JakovBegovic/Robot-upravljan-kontrolerom-v2/README.md

# Robot upravljan kontrolerom v2
[][cc-by-nc-sa]
<br>

Samostalan projekt studenta 2. godine diplomskog studija Jakova Begovića razvijen u svrhu učenja i razvijanja znanja. <br><br>
Koncipiran kao unaprjeđenje [projekta](https://github.com/JakovBegovic/Robot-upravljan-kontrolerom) razvijenog na 3. godini preddiplomskog studija. <br>
Uzima inspiraciju od prvotnog projekta i unaprjeđuje njegove značajke u svrhu povećane energetske učinkovitosti, korisničkog iskustva i funkcionalnosti.<br><br>

### Stanje razvoja dizajna za v2:
  - Razvijeni programski kodovi na prototipima električnih shema robot-auta i kontrolera ✅
  - Razvijene električne sheme robot-auta i kontrolera ✅
  - Dizajnirani PCB-i robot-auta i kontrolera ✅
  - Izrađeni PCB-i robot-auta i kontrolera ✅
  - Nabavljeni elektronički dijelovi robot-auta i kontrolera ✅
  - Razvijeni 2D modeli kućišta robot-auta i kontrolera ✅
  - Razvijeni 3D modeli kućišta robot-auta i kontrolera ❌
  - Isprintani 3D modeli kućišta robot-auta i kontrolera ❌
  - Elektronički dijelovi robot-auta i kontrolera povezani na PCB-ima ❌
  - Razvijeni programski kod prilagođen za sustave na PCB-ima ❌

<br>

### Korišteni alati:
  - KiCAD
    - razvoj električne sheme
    - dizajn PCB-a
      
  - LTSpice
    - simuliranje rada diskretnih sklopovskih komponenti
  
  - LibreCAD     
    - dizajn obruba PCB-a i 2D modela kućišta

  - VSC + PlatformIO
    - razvoj programskog koda

<br>

### Izjava o korištenju generativne umjetne inteligencije:
Cjelokupni razvoj sustava se temelji na Internetskim izvorima, knjigama i nastavnim materijalima Sveučilišta u Zagrebu. Generativna umjetna inteligencija nije korištena za razvoj ovoga sustava.

<br><br>
This work is licensed under a
[Creative Commons Attribution-NonCommercial-ShareAlike 4.0 International License][cc-by-nc-sa].

[][cc-by-nc-sa]

[cc-by-nc-sa]: http://creativecommons.org/licenses/by-nc-sa/4.0/
[cc-by-nc-sa-image]: https://licensebuttons.net/l/by-nc-sa/4.0/88x31.png
[cc-by-nc-sa-shield]: https://img.shields.io/badge/License-CC%20BY--NC--SA%204.0-lightgrey.svg
