JakovBegovic/Robot-upravljan-kontrolerom-v2/CAD modeli/2D/RC podloga.dxf

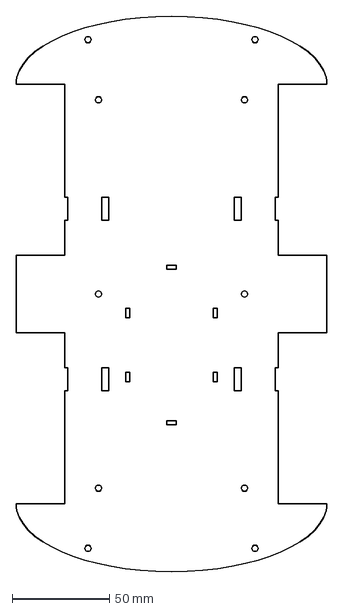
[picture p1: CAD file, 2026-11-08]
CAD modeli/2D/RC podloga.dxf
160.0 x 286.0 mm
