JakovBegovic/Robot-upravljan-kontrolerom-v2/CAD modeli/3D/Kontroler/K Kuciste.FCStd

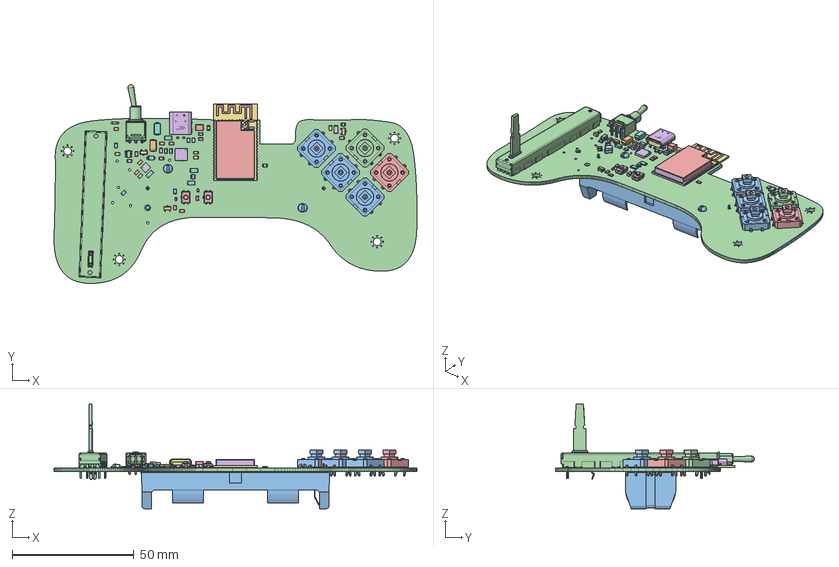
[picture p2: CAD file, 2026-11-08]
CAD modeli/3D/Kontroler/K Kuciste.FCStd
148.9 x 81.5 x 42.9 mm
C_0805_2012Metric
R_0805_2012Metric
R_0805_2012Metric002
C_1210_3225Metric
EVQP2B02B2
C_0805_2012Metric002
R_1206_3216Metric
D_SOD-882D
R_0805_2012Metric004
SOT-23-6
EVQP2B02B001
R_0805_2012Metric006
R_0805_2012Metric008
60816e3e-9268-11ed-8af4-a0cec80452fd_part
6081710e-9268-11ed-8af4-a0cec80452fd_part
6081737a-9268-11ed-8af4-a0cec80452fd_part
D_SOD_523
C0201_20210301.STEP^C0201_20210301.STEP_Submodel-C0201_part_DesignRootModel_PCB_ESP32-WROVER-E_V1(2)_PCB_ESP32-WROVER-E_V1
C0201_20210301.STEP^C0201_20210301.STEP_Submodel-C0201_part_DesignRootModel_PCB_ESP32-WROVER-E_V1(2)_PCB_ESP32-WROVER-E_V001
C0201_20210301.STEP^C0201_20210301.STEP_Submodel-C0201_part_DesignRootModel_PCB_ESP32-WROVER-E_V1(2)_PCB_ESP32-WROVER-E_V002
C0201_20210301.STEP^C0201_20210301.STEP_Submodel-C0201_part_DesignRootModel_PCB_ESP32-WROVER-E_V1(2)_PCB_ESP32-WROVER-E_V003
C0201_20210301.STEP^C0201_20210301.STEP_Submodel-C0201_part_DesignRootModel_PCB_ESP32-WROVER-E_V1(2)_PCB_ESP32-WROVER-E_V004
C0201_20210301.STEP^C0201_20210301.STEP_Submodel-C0201_part_DesignRootModel_PCB_ESP32-WROVER-E_V1(2)_PCB_ESP32-WROVER-E_V005
C0201_20210301.STEP^C0201_20210301.STEP_Submodel-C0201_part_DesignRootModel_PCB_ESP32-WROVER-E_V1(2)_PCB_ESP32-WROVER-E_V006
C0201_20210301.STEP^C0201_20210301.STEP_Submodel-C0201_part_DesignRootModel_PCB_ESP32-WROVER-E_V1(2)_PCB_ESP32-WROVER-E_V007
C0201_20210301.STEP^C0201_20210301.STEP_Submodel-C0201_part_DesignRootModel_PCB_ESP32-WROVER-E_V1(2)_PCB_ESP32-WROVER-E_V008
C0201_20210301.STEP^C0201_20210301.STEP_Submodel-C0201_part_DesignRootModel_PCB_ESP32-WROVER-E_V1(2)_PCB_ESP32-WROVER-E_V009
C0201_20210301.STEP^C0201_20210301.STEP_Submodel-C0201_part_DesignRootModel_PCB_ESP32-WROVER-E_V1(2)_PCB_ESP32-WROVER-E_V010
C0201_20210301.STEP^C0201_20210301.STEP_Submodel-C0201_part_DesignRootModel_PCB_ESP32-WROVER-E_V1(2)_PCB_ESP32-WROVER-E_V011
C0201_20210301.STEP^C0201_20210301.STEP_Submodel-C0201_part_DesignRootModel_PCB_ESP32-WROVER-E_V1(2)_PCB_ESP32-WROVER-E_V012
C0201_20210301.STEP^C0201_20210301.STEP_Submodel-C0201_part_DesignRootModel_PCB_ESP32-WROVER-E_V1(2)_PCB_ESP32-WROVER-E_V013
DFN1006.STEP^DFN1006.STEP_Submodel-SOD882_part_DesignRootModel_PCB_ESP32-WROVER-E_V1(2)_PCB_ESP32-WROVER-E_V1
ESP32_5x5_20210301.STEP^ESP32_5x5_20210301.STEP_Submodel-QFN48EB_0P35_5_part_DesignRootModel_PCB_ESP32-WROVER-E_V1(2)_PCB_ESP32-WROVER-E_V1
C0402_20210301.STEP^C0402_20210301.STEP_Submodel-C0402_part_DesignRootModel_PCB_ESP32-WROVER-E_V1(2)_PCB_ESP32-WROVER-E_V1
trace_1^Submodel-MINI_ANT_TYPEB_1501846164_part_DesignRootModel_PCB_ESP32-WROVER-E_V1(2)_PCB_ESP32-WROVER-E_V1
XTAL3225_20210301.STEP^XTAL3225_20210301.STEP_Submodel-3225_part_DesignRootModel_PCB_ESP32-WROVER-E_V1(2)_PCB_ESP32-WROVER-E_V1
R0201_20210301.STEP^R0201_20210301.STEP_Submodel-R0201A_part_DesignRootModel_PCB_ESP32-WROVER-E_V1(2)_PCB_ESP32-WROVER-E_V1
R0201_20210301.STEP^R0201_20210301.STEP_Submodel-R0201_part_DesignRootModel_PCB_ESP32-WROVER-E_V1(2)_PCB_ESP32-WROVER-E_V1
L0201_20210301.STEP^L0201_20210301.STEP_Submodel-L0201_part_DesignRootModel_PCB_ESP32-WROVER-E_V1(2)_PCB_ESP32-WROVER-E_V1
R0201_20210301.STEP^R0201_20210301.STEP_Submodel-R0201_part_DesignRootModel_PCB_ESP32-WROVER-E_V1(2)_PCB_ESP32-WROVER-E_V001
R0201_20210301.STEP^R0201_20210301.STEP_Submodel-R0201_part_DesignRootModel_PCB_ESP32-WROVER-E_V1(2)_PCB_ESP32-WROVER-E_V002
R0201_20210301.STEP^R0201_20210301.STEP_Submodel-R0201_part_DesignRootModel_PCB_ESP32-WROVER-E_V1(2)_PCB_ESP32-WROVER-E_V003
L0201_20210301.STEP^L0201_20210301.STEP_Submodel-L0201_part_DesignRootModel_PCB_ESP32-WROVER-E_V1(2)_PCB_ESP32-WROVER-E_V001
PSRAM_20210301.STEP^PSRAM_20210301.STEP_Submodel-SOIC-8P_part_DesignRootModel_PCB_ESP32-WROVER-E_V1(2)_PCB_ESP32-WROVER-E_V1
R0201_20210301.STEP^R0201_20210301.STEP_Submodel-R0201_part_DesignRootModel_PCB_ESP32-WROVER-E_V1(2)_PCB_ESP32-WROVER-E_V004
R0201_20210301.STEP^R0201_20210301.STEP_Submodel-R0201_part_DesignRootModel_PCB_ESP32-WROVER-E_V1(2)_PCB_ESP32-WROVER-E_V005
R0201_20210301.STEP^R0201_20210301.STEP_Submodel-R0201_part_DesignRootModel_PCB_ESP32-WROVER-E_V1(2)_PCB_ESP32-WROVER-E_V006
R0201_20210301.STEP^R0201_20210301.STEP_Submodel-R0201_part_DesignRootModel_PCB_ESP32-WROVER-E_V1(2)_PCB_ESP32-WROVER-E_V007
R0201_20210301.STEP^R0201_20210301.STEP_Submodel-R0201_part_DesignRootModel_PCB_ESP32-WROVER-E_V1(2)_PCB_ESP32-WROVER-E_V008
SOIC8_208_20210301.STEP^SOIC8_208_20210301.STEP_Submodel-SOIC08-WN_part_DesignRootModel_PCB_ESP32-WROVER-E_V1(2)_PCB_ESP32-WROVER-E_V1
C0201_20210301.STEP^C0201_20210301.STEP_Submodel-C0201_part_DesignRootModel_PCB_ESP32-WROVER-E_V1(2)_PCB_ESP32-WROVER-E_V014
uid__4-19^DesignRootModel_PCB_ESP32-WROVER-E_V1(2)_PCB_ESP32-WROVER-E_V1
uid__4-20^DesignRootModel_PCB_ESP32-WROVER-E_V1(2)_PCB_ESP32-WROVER-E_V1
uid__4-21^DesignRootModel_PCB_ESP32-WROVER-E_V1(2)_PCB_ESP32-WROVER-E_V1
uid__4-22^DesignRootModel_PCB_ESP32-WROVER-E_V1(2)_PCB_ESP32-WROVER-E_V1
uid__4-23^DesignRootModel_PCB_ESP32-WROVER-E_V1(2)_PCB_ESP32-WROVER-E_V1
uid__4-24^DesignRootModel_PCB_ESP32-WROVER-E_V1(2)_PCB_ESP32-WROVER-E_V1
uid__4-25^DesignRootModel_PCB_ESP32-WROVER-E_V1(2)_PCB_ESP32-WROVER-E_V1
uid__4-26^DesignRootModel_PCB_ESP32-WROVER-E_V1(2)_PCB_ESP32-WROVER-E_V1
uid__4-27^DesignRootModel_PCB_ESP32-WROVER-E_V1(2)_PCB_ESP32-WROVER-E_V1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
