JakovBegovic/Robot-upravljan-kontrolerom-v2/CAD modeli/3D/Robot-auto/Podloga.FCStd

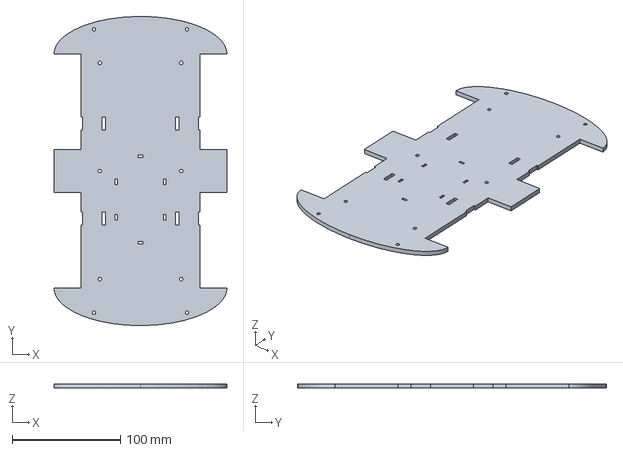
[picture p3: CAD file, 2026-11-08]
CAD modeli/3D/Robot-auto/Podloga.FCStd
160.0 x 286.0 x 4.00 mm
