JakovBegovic/Robot-upravljan-kontrolerom-v2/Električne sheme/Robot-auto/Robot-auto.step

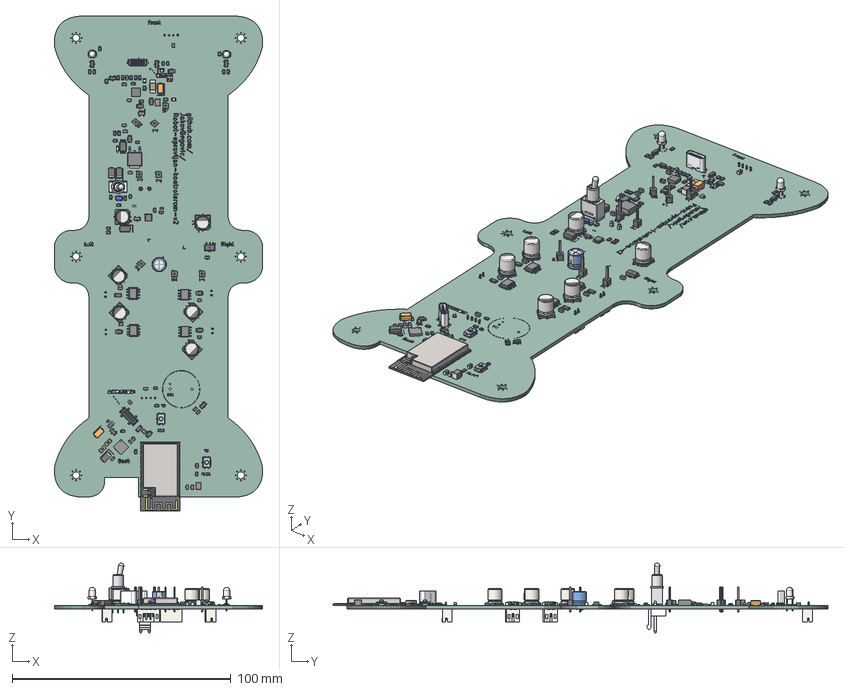
[picture p4: CAD file, 2026-10-22]
Električne sheme/Robot-auto/Robot-auto.step
95.3 x 226.3 x 32.0 mm
025002-01643-a.testprt x 2
D_SOD_523 x 2
R_0805_2012Metric x 41
C_0805_2012Metric x 20
C_1210_3225Metric x 2
PinHeader_1x01_P254mm_Vertical x 8
R_1206_3216Metric x 10
SOT-23 x 6
CP_Elec_63x77 x 6
HSMG-C110
PinsArrayLR x 2
LED_D3.0mm_Clear x 2
D_SMA x 4
C_0603_1608Metric
ThermalPin
PinsArrayTB
PinsArrayL x 2
PinsArrayR
USB4130-GF-C_PART1
TSSOP-8_4.4x3mm_P0.65mm
LED_0805_2012Metric x 3
USB4120-03-C
Fuse_1206_3216Metric
C0201_20210301.STEP^C0201_20210301.STEP_Submodel-C0201_part_ DesignRootModel_PCB_ESP32-WROVER-E_V1(2)_PCB_ESP32-WROVER-E_V1 x 15
DFN1006.STEP^DFN1006.STEP_Submodel-SOD882_part_DesignRootModel_PCB_ ESP32-WROVER-E_V1(2)_PCB_ESP32-WROVER-E_V1
ESP32_5x5_20210301.STEP^ESP32_5x5_20210301.STEP_Submodel-QFN48EB_0P35_ 5_part_DesignRootModel_PCB_ESP32-WROVER-E_V1(2)_PCB_ESP32-WROVER-E_V1
C0402_20210301.STEP^C0402_20210301.STEP_Submodel-C0402_part_ DesignRootModel_PCB_ESP32-WROVER-E_V1(2)_PCB_ESP32-WROVER-E_V1
trace_1^Submodel-MINI_ANT_TYPEB_1501846164_part_DesignRootModel_PCB_ ESP32-WROVER-E_V1(2)_PCB_ESP32-WROVER-E_V1
XTAL3225_20210301.STEP^XTAL3225_20210301.STEP_Submodel-3225_part_ DesignRootModel_PCB_ESP32-WROVER-E_V1(2)_PCB_ESP32-WROVER-E_V1
R0201_20210301.STEP^R0201_20210301.STEP_Submodel-R0201A_part_ DesignRootModel_PCB_ESP32-WROVER-E_V1(2)_PCB_ESP32-WROVER-E_V1
R0201_20210301.STEP^R0201_20210301.STEP_Submodel-R0201_part_ DesignRootModel_PCB_ESP32-WROVER-E_V1(2)_PCB_ESP32-WROVER-E_V1 x 9
L0201_20210301.STEP^L0201_20210301.STEP_Submodel-L0201_part_ DesignRootModel_PCB_ESP32-WROVER-E_V1(2)_PCB_ESP32-WROVER-E_V1 x 2
PSRAM_20210301.STEP^PSRAM_20210301.STEP_Submodel-SOIC-8P_part_ DesignRootModel_PCB_ESP32-WROVER-E_V1(2)_PCB_ESP32-WROVER-E_V1
SOIC8_208_20210301.STEP^SOIC8_208_20210301.STEP_Submodel-SOIC08-WN_ part_DesignRootModel_PCB_ESP32-WROVER-E_V1(2)_PCB_ESP32-WROVER-E_V1
uid__4-19^DesignRootModel_PCB_ESP32-WROVER-E_V1(2)_PCB_ESP32-WROVER-E_ V1
uid__4-20^DesignRootModel_PCB_ESP32-WROVER-E_V1(2)_PCB_ESP32-WROVER-E_ V1
uid__4-21^DesignRootModel_PCB_ESP32-WROVER-E_V1(2)_PCB_ESP32-WROVER-E_ V1
uid__4-22^DesignRootModel_PCB_ESP32-WROVER-E_V1(2)_PCB_ESP32-WROVER-E_ V1
uid__4-23^DesignRootModel_PCB_ESP32-WROVER-E_V1(2)_PCB_ESP32-WROVER-E_ V1
uid__4-24^DesignRootModel_PCB_ESP32-WROVER-E_V1(2)_PCB_ESP32-WROVER-E_ V1
uid__4-25^DesignRootModel_PCB_ESP32-WROVER-E_V1(2)_PCB_ESP32-WROVER-E_ V1
uid__4-26^DesignRootModel_PCB_ESP32-WROVER-E_V1(2)_PCB_ESP32-WROVER-E_ V1
uid__4-27^DesignRootModel_PCB_ESP32-WROVER-E_V1(2)_PCB_ESP32-WROVER-E_ V1
uid__4-28^DesignRootModel_PCB_ESP32-WROVER-E_V1(2)_PCB_ESP32-WROVER-E_ V1
uid__4-29^DesignRootModel_PCB_ESP32-WROVER-E_V1(2)_PCB_ESP32-WROVER-E_ V1
uid__4-30^DesignRootModel_PCB_ESP32-WROVER-E_V1(2)_PCB_ESP32-WROVER-E_ V1
uid__4-31^DesignRootModel_PCB_ESP32-WROVER-E_V1(2)_PCB_ESP32-WROVER-E_ V1
uid__4-32^DesignRootModel_PCB_ESP32-WROVER-E_V1(2)_PCB_ESP32-WROVER-E_ V1
uid__4-33^DesignRootModel_PCB_ESP32-WROVER-E_V1(2)_PCB_ESP32-WROVER-E_ V1
uid__4-34^DesignRootModel_PCB_ESP32-WROVER-E_V1(2)_PCB_ESP32-WROVER-E_ V1
uid__4-35^DesignRootModel_PCB_ESP32-WROVER-E_V1(2)_PCB_ESP32-WROVER-E_ V1
uid__4-36^DesignRootModel_PCB_ESP32-WROVER-E_V1(2)_PCB_ESP32-WROVER-E_ V1
uid__4-37^DesignRootModel_PCB_ESP32-WROVER-E_V1(2)_PCB_ESP32-WROVER-E_ V1
uid__4-38^DesignRootModel_PCB_ESP32-WROVER-E_V1(2)_PCB_ESP32-WROVER-E_ V1
uid__4-39^DesignRootModel_PCB_ESP32-WROVER-E_V1(2)_PCB_ESP32-WROVER-E_ V1
uid__4-40^DesignRootModel_PCB_ESP32-WROVER-E_V1(2)_PCB_ESP32-WROVER-E_ V1
uid__4-41^DesignRootModel_PCB_ESP32-WROVER-E_V1(2)_PCB_ESP32-WROVER-E_ V1
uid__4-42^DesignRootModel_PCB_ESP32-WROVER-E_V1(2)_PCB_ESP32-WROVER-E_ V1
uid__4-43^DesignRootModel_PCB_ESP32-WROVER-E_V1(2)_PCB_ESP32-WROVER-E_ V1
uid__4-44^DesignRootModel_PCB_ESP32-WROVER-E_V1(2)_PCB_ESP32-WROVER-E_ V1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
