JakovBegovic/Robot-upravljan-kontrolerom-v2/CAD modeli/3D/Kontroler/Kontroler.step

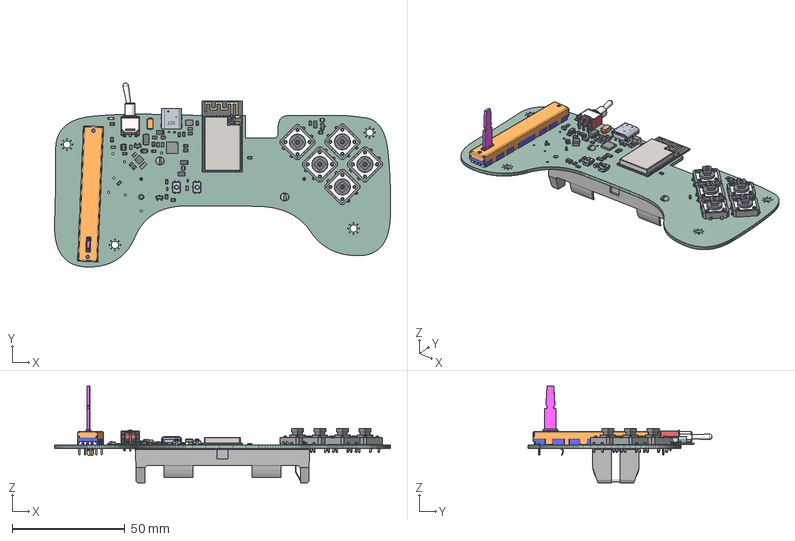
[picture p5: CAD file, 2026-11-04]
CAD modeli/3D/Kontroler/Kontroler.step
148.9 x 81.5 x 42.9 mm
C_0805_2012Metric x 10
R_0805_2012Metric x 19
C_1210_3225Metric
EVQP2B02B2 x 2
R_1206_3216Metric x 3
D_SOD-882D x 2
SOT-23-6
6081697a-9268-11ed-8af4-a0cec80452fd_part
60816e3e-9268-11ed-8af4-a0cec80452fd_part
6081710e-9268-11ed-8af4-a0cec80452fd_part
6081737a-9268-11ed-8af4-a0cec80452fd_part
D_SOD_523 x 2
C0201_20210301.STEP^C0201_20210301.STEP_Submodel-C0201_part_ DesignRootModel_PCB_ESP32-WROVER-E_V1(2)_PCB_ESP32-WROVER-E_V1 x 15
DFN1006.STEP^DFN1006.STEP_Submodel-SOD882_part_DesignRootModel_PCB_ ESP32-WROVER-E_V1(2)_PCB_ESP32-WROVER-E_V1
ESP32_5x5_20210301.STEP^ESP32_5x5_20210301.STEP_Submodel-QFN48EB_0P35_ 5_part_DesignRootModel_PCB_ESP32-WROVER-E_V1(2)_PCB_ESP32-WROVER-E_V1
C0402_20210301.STEP^C0402_20210301.STEP_Submodel-C0402_part_ DesignRootModel_PCB_ESP32-WROVER-E_V1(2)_PCB_ESP32-WROVER-E_V1
trace_1^Submodel-MINI_ANT_TYPEB_1501846164_part_DesignRootModel_PCB_ ESP32-WROVER-E_V1(2)_PCB_ESP32-WROVER-E_V1
XTAL3225_20210301.STEP^XTAL3225_20210301.STEP_Submodel-3225_part_ DesignRootModel_PCB_ESP32-WROVER-E_V1(2)_PCB_ESP32-WROVER-E_V1
R0201_20210301.STEP^R0201_20210301.STEP_Submodel-R0201A_part_ DesignRootModel_PCB_ESP32-WROVER-E_V1(2)_PCB_ESP32-WROVER-E_V1
R0201_20210301.STEP^R0201_20210301.STEP_Submodel-R0201_part_ DesignRootModel_PCB_ESP32-WROVER-E_V1(2)_PCB_ESP32-WROVER-E_V1 x 9
L0201_20210301.STEP^L0201_20210301.STEP_Submodel-L0201_part_ DesignRootModel_PCB_ESP32-WROVER-E_V1(2)_PCB_ESP32-WROVER-E_V1 x 2
PSRAM_20210301.STEP^PSRAM_20210301.STEP_Submodel-SOIC-8P_part_ DesignRootModel_PCB_ESP32-WROVER-E_V1(2)_PCB_ESP32-WROVER-E_V1
SOIC8_208_20210301.STEP^SOIC8_208_20210301.STEP_Submodel-SOIC08-WN_ part_DesignRootModel_PCB_ESP32-WROVER-E_V1(2)_PCB_ESP32-WROVER-E_V1
uid__4-19^DesignRootModel_PCB_ESP32-WROVER-E_V1(2)_PCB_ESP32-WROVER-E_ V1
uid__4-20^DesignRootModel_PCB_ESP32-WROVER-E_V1(2)_PCB_ESP32-WROVER-E_ V1
uid__4-21^DesignRootModel_PCB_ESP32-WROVER-E_V1(2)_PCB_ESP32-WROVER-E_ V1
uid__4-22^DesignRootModel_PCB_ESP32-WROVER-E_V1(2)_PCB_ESP32-WROVER-E_ V1
uid__4-23^DesignRootModel_PCB_ESP32-WROVER-E_V1(2)_PCB_ESP32-WROVER-E_ V1
uid__4-24^DesignRootModel_PCB_ESP32-WROVER-E_V1(2)_PCB_ESP32-WROVER-E_ V1
uid__4-25^DesignRootModel_PCB_ESP32-WROVER-E_V1(2)_PCB_ESP32-WROVER-E_ V1
uid__4-26^DesignRootModel_PCB_ESP32-WROVER-E_V1(2)_PCB_ESP32-WROVER-E_ V1
uid__4-27^DesignRootModel_PCB_ESP32-WROVER-E_V1(2)_PCB_ESP32-WROVER-E_ V1
uid__4-28^DesignRootModel_PCB_ESP32-WROVER-E_V1(2)_PCB_ESP32-WROVER-E_ V1
uid__4-29^DesignRootModel_PCB_ESP32-WROVER-E_V1(2)_PCB_ESP32-WROVER-E_ V1
uid__4-30^DesignRootModel_PCB_ESP32-WROVER-E_V1(2)_PCB_ESP32-WROVER-E_ V1
uid__4-31^DesignRootModel_PCB_ESP32-WROVER-E_V1(2)_PCB_ESP32-WROVER-E_ V1
uid__4-32^DesignRootModel_PCB_ESP32-WROVER-E_V1(2)_PCB_ESP32-WROVER-E_ V1
uid__4-33^DesignRootModel_PCB_ESP32-WROVER-E_V1(2)_PCB_ESP32-WROVER-E_ V1
uid__4-34^DesignRootModel_PCB_ESP32-WROVER-E_V1(2)_PCB_ESP32-WROVER-E_ V1
uid__4-35^DesignRootModel_PCB_ESP32-WROVER-E_V1(2)_PCB_ESP32-WROVER-E_ V1
uid__4-36^DesignRootModel_PCB_ESP32-WROVER-E_V1(2)_PCB_ESP32-WROVER-E_ V1
uid__4-37^DesignRootModel_PCB_ESP32-WROVER-E_V1(2)_PCB_ESP32-WROVER-E_ V1
uid__4-38^DesignRootModel_PCB_ESP32-WROVER-E_V1(2)_PCB_ESP32-WROVER-E_ V1
uid__4-39^DesignRootModel_PCB_ESP32-WROVER-E_V1(2)_PCB_ESP32-WROVER-E_ V1
uid__4-40^DesignRootModel_PCB_ESP32-WROVER-E_V1(2)_PCB_ESP32-WROVER-E_ V1
uid__4-41^DesignRootModel_PCB_ESP32-WROVER-E_V1(2)_PCB_ESP32-WROVER-E_ V1
uid__4-42^DesignRootModel_PCB_ESP32-WROVER-E_V1(2)_PCB_ESP32-WROVER-E_ V1
uid__4-43^DesignRootModel_PCB_ESP32-WROVER-E_V1(2)_PCB_ESP32-WROVER-E_ V1
uid__4-44^DesignRootModel_PCB_ESP32-WROVER-E_V1(2)_PCB_ESP32-WROVER-E_ V1
uid__4-45^DesignRootModel_PCB_ESP32-WROVER-E_V1(2)_PCB_ESP32-WROVER-E_ V1
uid__4-46^DesignRootModel_PCB_ESP32-WROVER-E_V1(2)_PCB_ESP32-WROVER-E_ V1
uid__4-47^DesignRootModel_PCB_ESP32-WROVER-E_V1(2)_PCB_ESP32-WROVER-E_ V1
uid__4-48^DesignRootModel_PCB_ESP32-WROVER-E_V1(2)_PCB_ESP32-WROVER-E_ V1
uid__4-49^DesignRootModel_PCB_ESP32-WROVER-E_V1(2)_PCB_ESP32-WROVER-E_ V1
uid__4-50^DesignRootModel_PCB_ESP32-WROVER-E_V1(2)_PCB_ESP32-WROVER-E_ V1
uid__4-51^DesignRootModel_PCB_ESP32-WROVER-E_V1(2)_PCB_ESP32-WROVER-E_ V1
uid__4-52^DesignRootModel_PCB_ESP32-WROVER-E_V1(2)_PCB_ESP32-WROVER-E_ V1
uid__4-53^DesignRootModel_PCB_ESP32-WROVER-E_V1(2)_PCB_ESP32-WROVER-E_ V1
uid__4-54^DesignRootModel_PCB_ESP32-WROVER-E_V1(2)_PCB_ESP32-WROVER-E_ V1
uid__4-55^DesignRootModel_PCB_ESP32-WROVER-E_V1(2)_PCB_ESP32-WROVER-E_ V1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
