JakovBegovic/Robot-upravljan-kontrolerom-v2/CAD modeli/2D/PCB K obrub.dxf

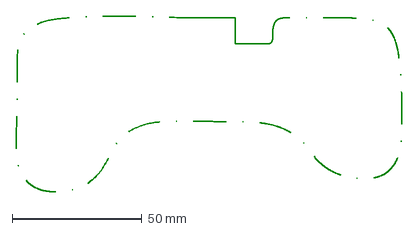
[picture p6: CAD file, 2026-11-08]
CAD modeli/2D/PCB K obrub.dxf
148.9 x 67.7 mm
