JakovBegovic/Robot-upravljan-kontrolerom-v2/CAD modeli/2D/K podloga tlocrt.dxf

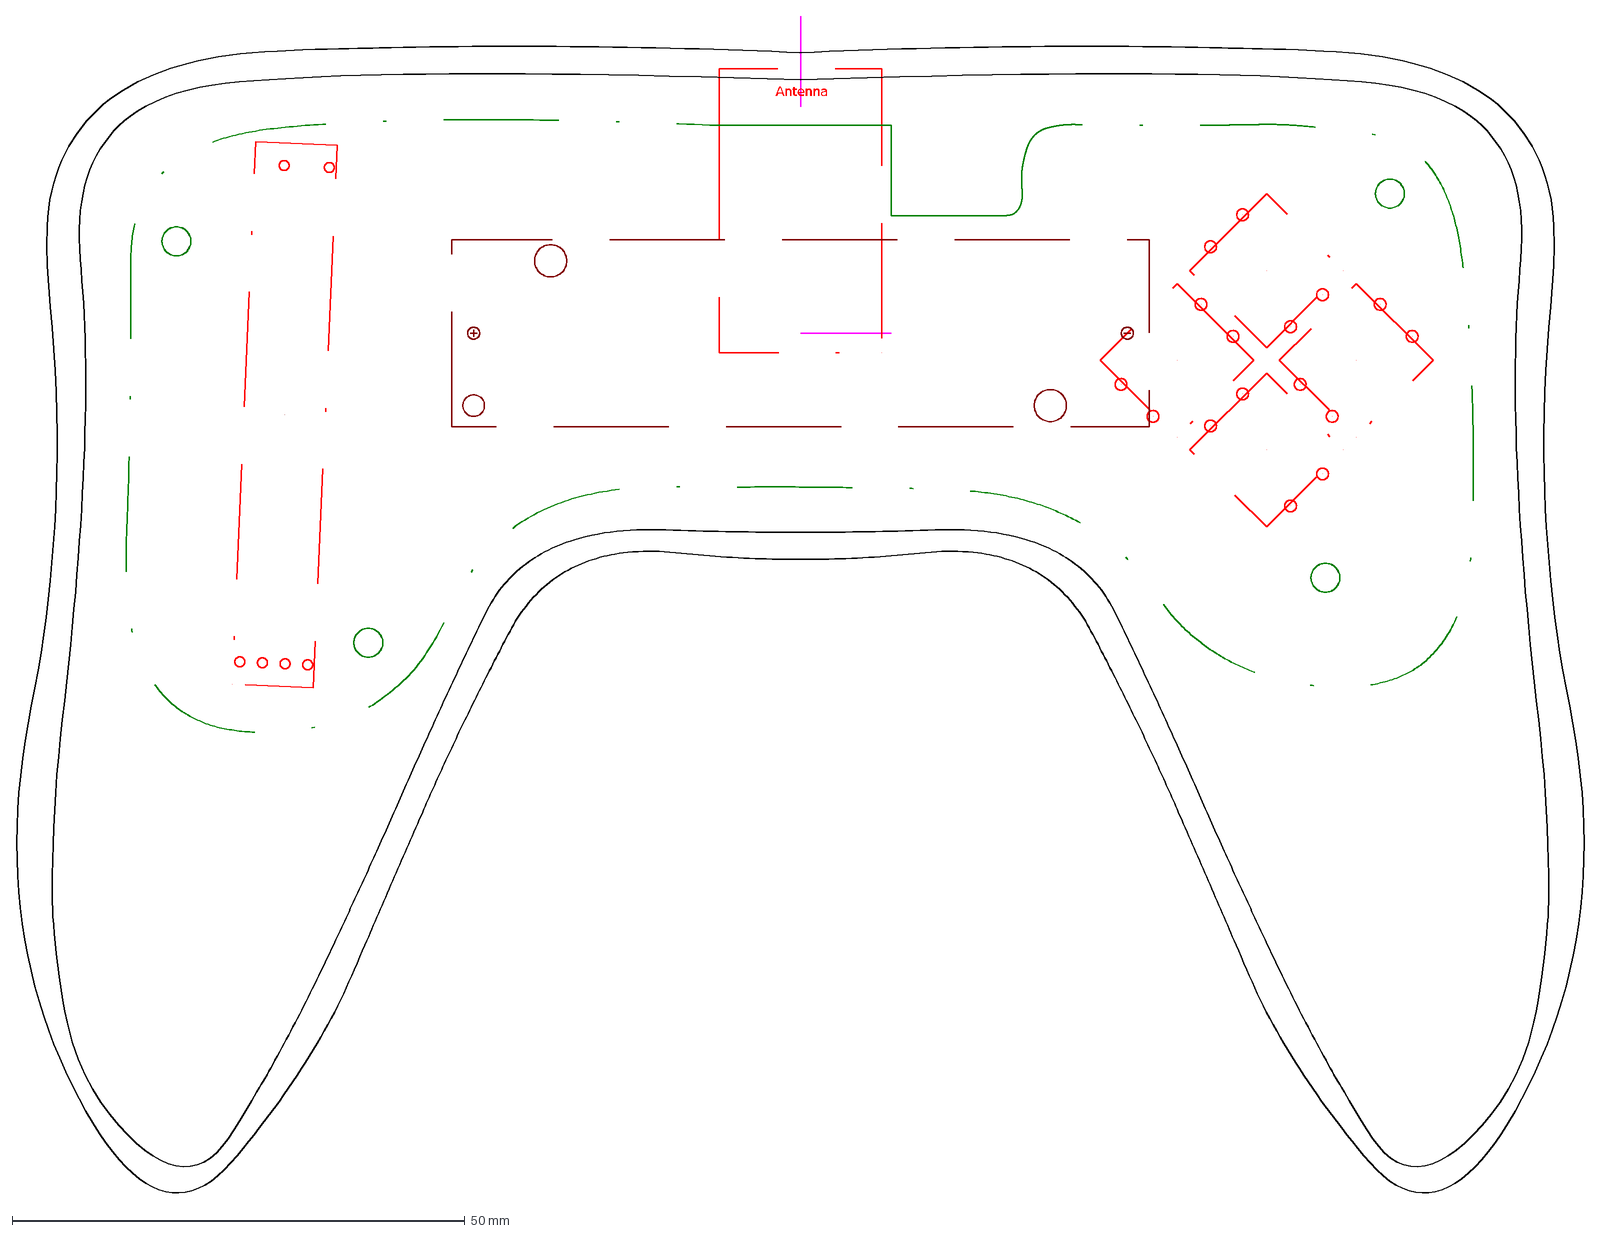
[picture p7: CAD file, 2026-11-08]
CAD modeli/2D/K podloga tlocrt.dxf
Antenna
