JakovBegovic/Robot-upravljan-kontrolerom-v2/CAD modeli/2D/PCB RC obrub.dxf

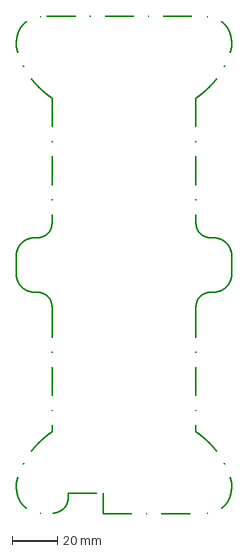
[picture p8: CAD file, 2026-10-21]
CAD modeli/2D/PCB RC obrub.dxf
95.3 x 220.0 mm
