JakovBegovic/Robot-upravljan-kontrolerom-v2/(list of files, cad)

Other CAD files:
CAD modeli/2D/RC Podloga tlocrt.dxf
CAD modeli/3D/Robot-auto/Robot-auto.step
