JakovBegovic/Robot-upravljan-kontrolerom-v2/Električne sheme/Kontroler/Kontroler.pdf

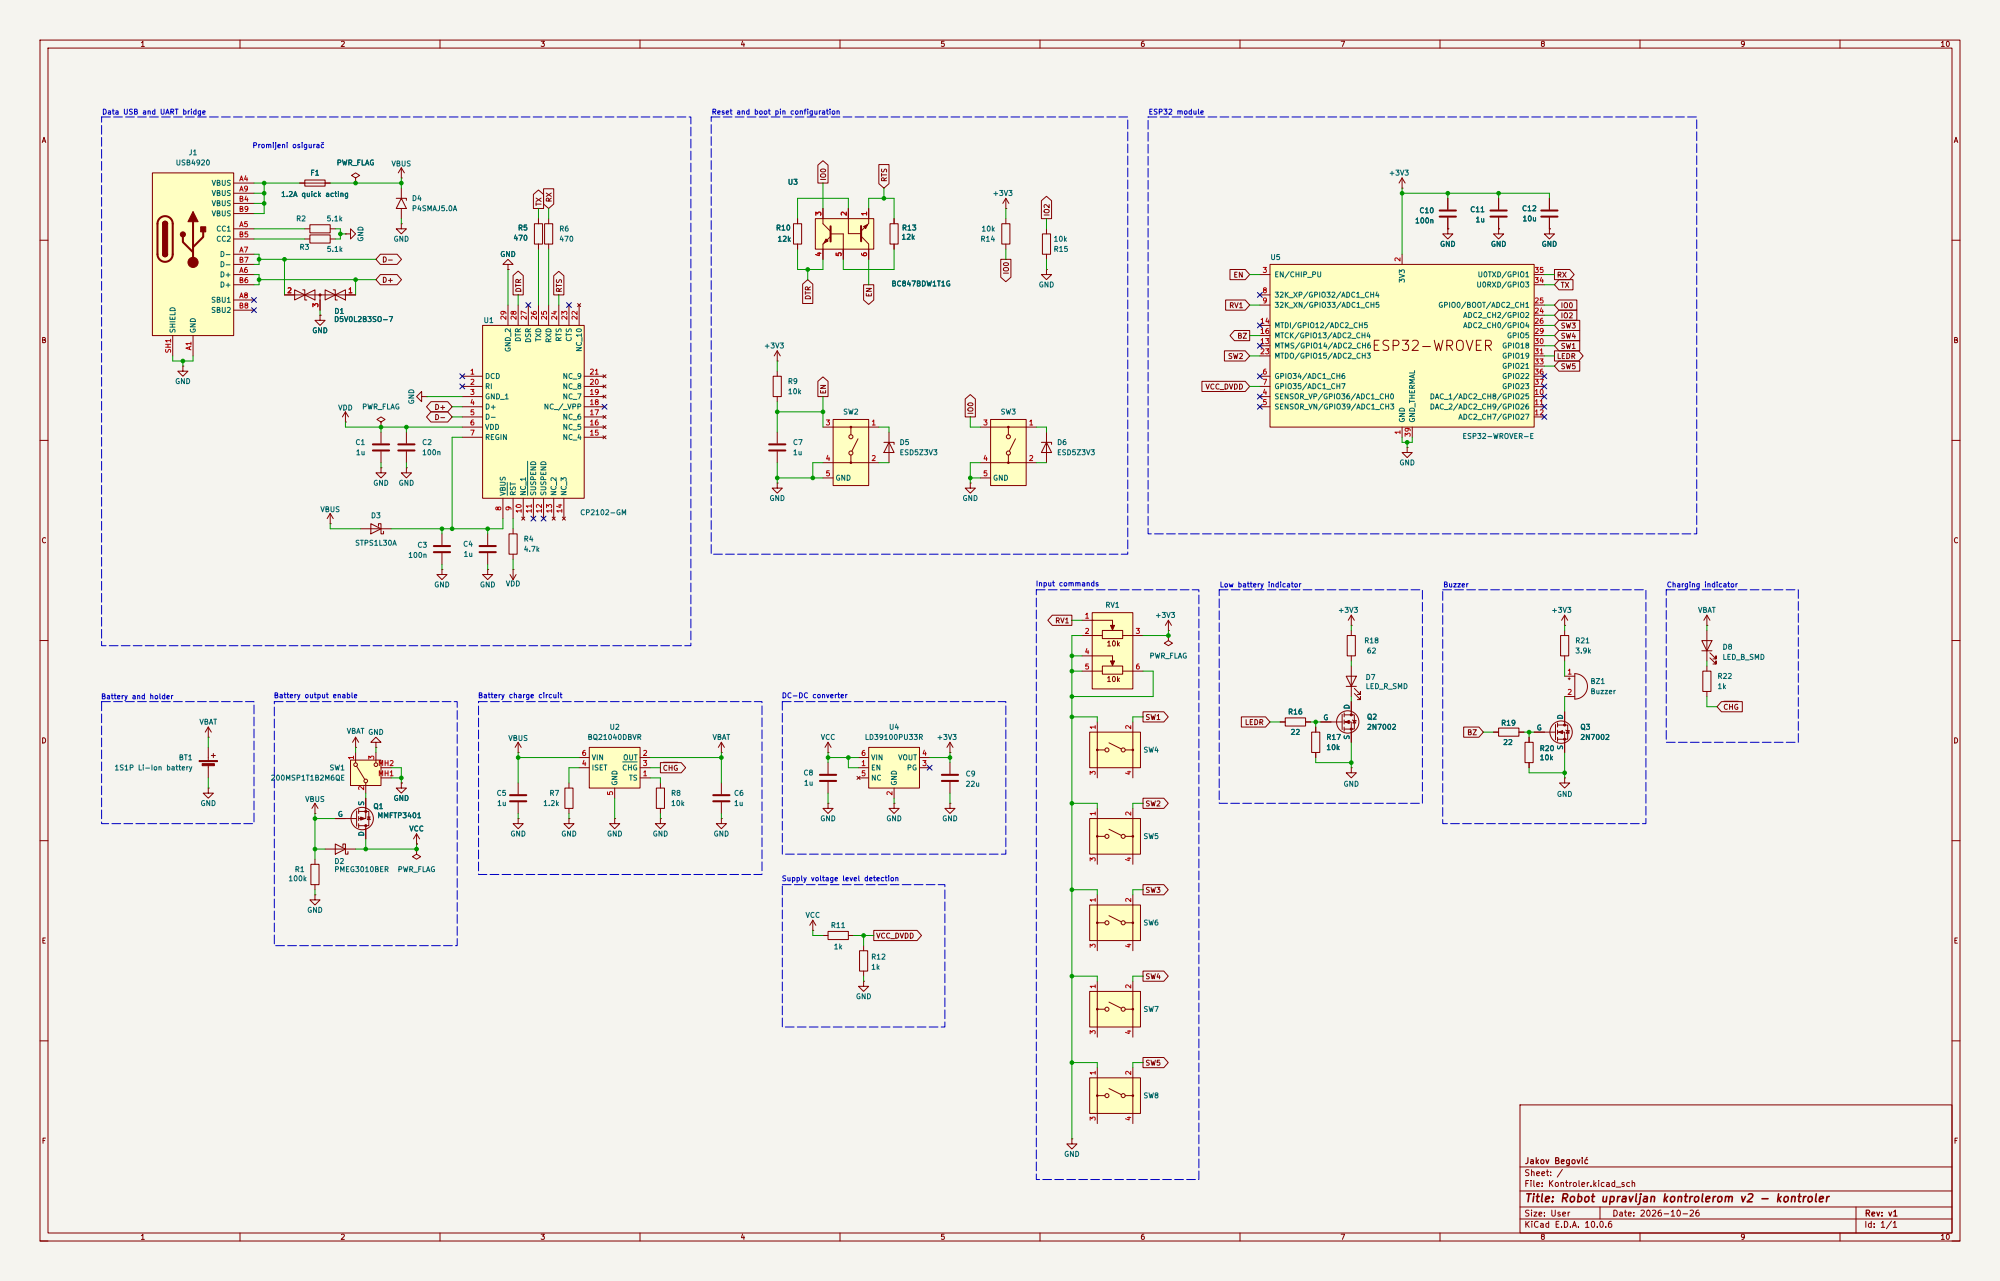
[picture p9: page 1]

Data USB and UART bridge
J1 USB4920 GND

Jakov Begović
Sheet: /
File: Kontroler.kicad_sch
Title: Robot upravljan kontrolerom v2 - kontroler

Size: User | Rev: v1
KiCad E.D.A. 10.0.6 | Id: 1/1
