JakovBegovic/Robot-upravljan-kontrolerom-v2/Električne sheme/Robot-auto/Robot-auto.pdf

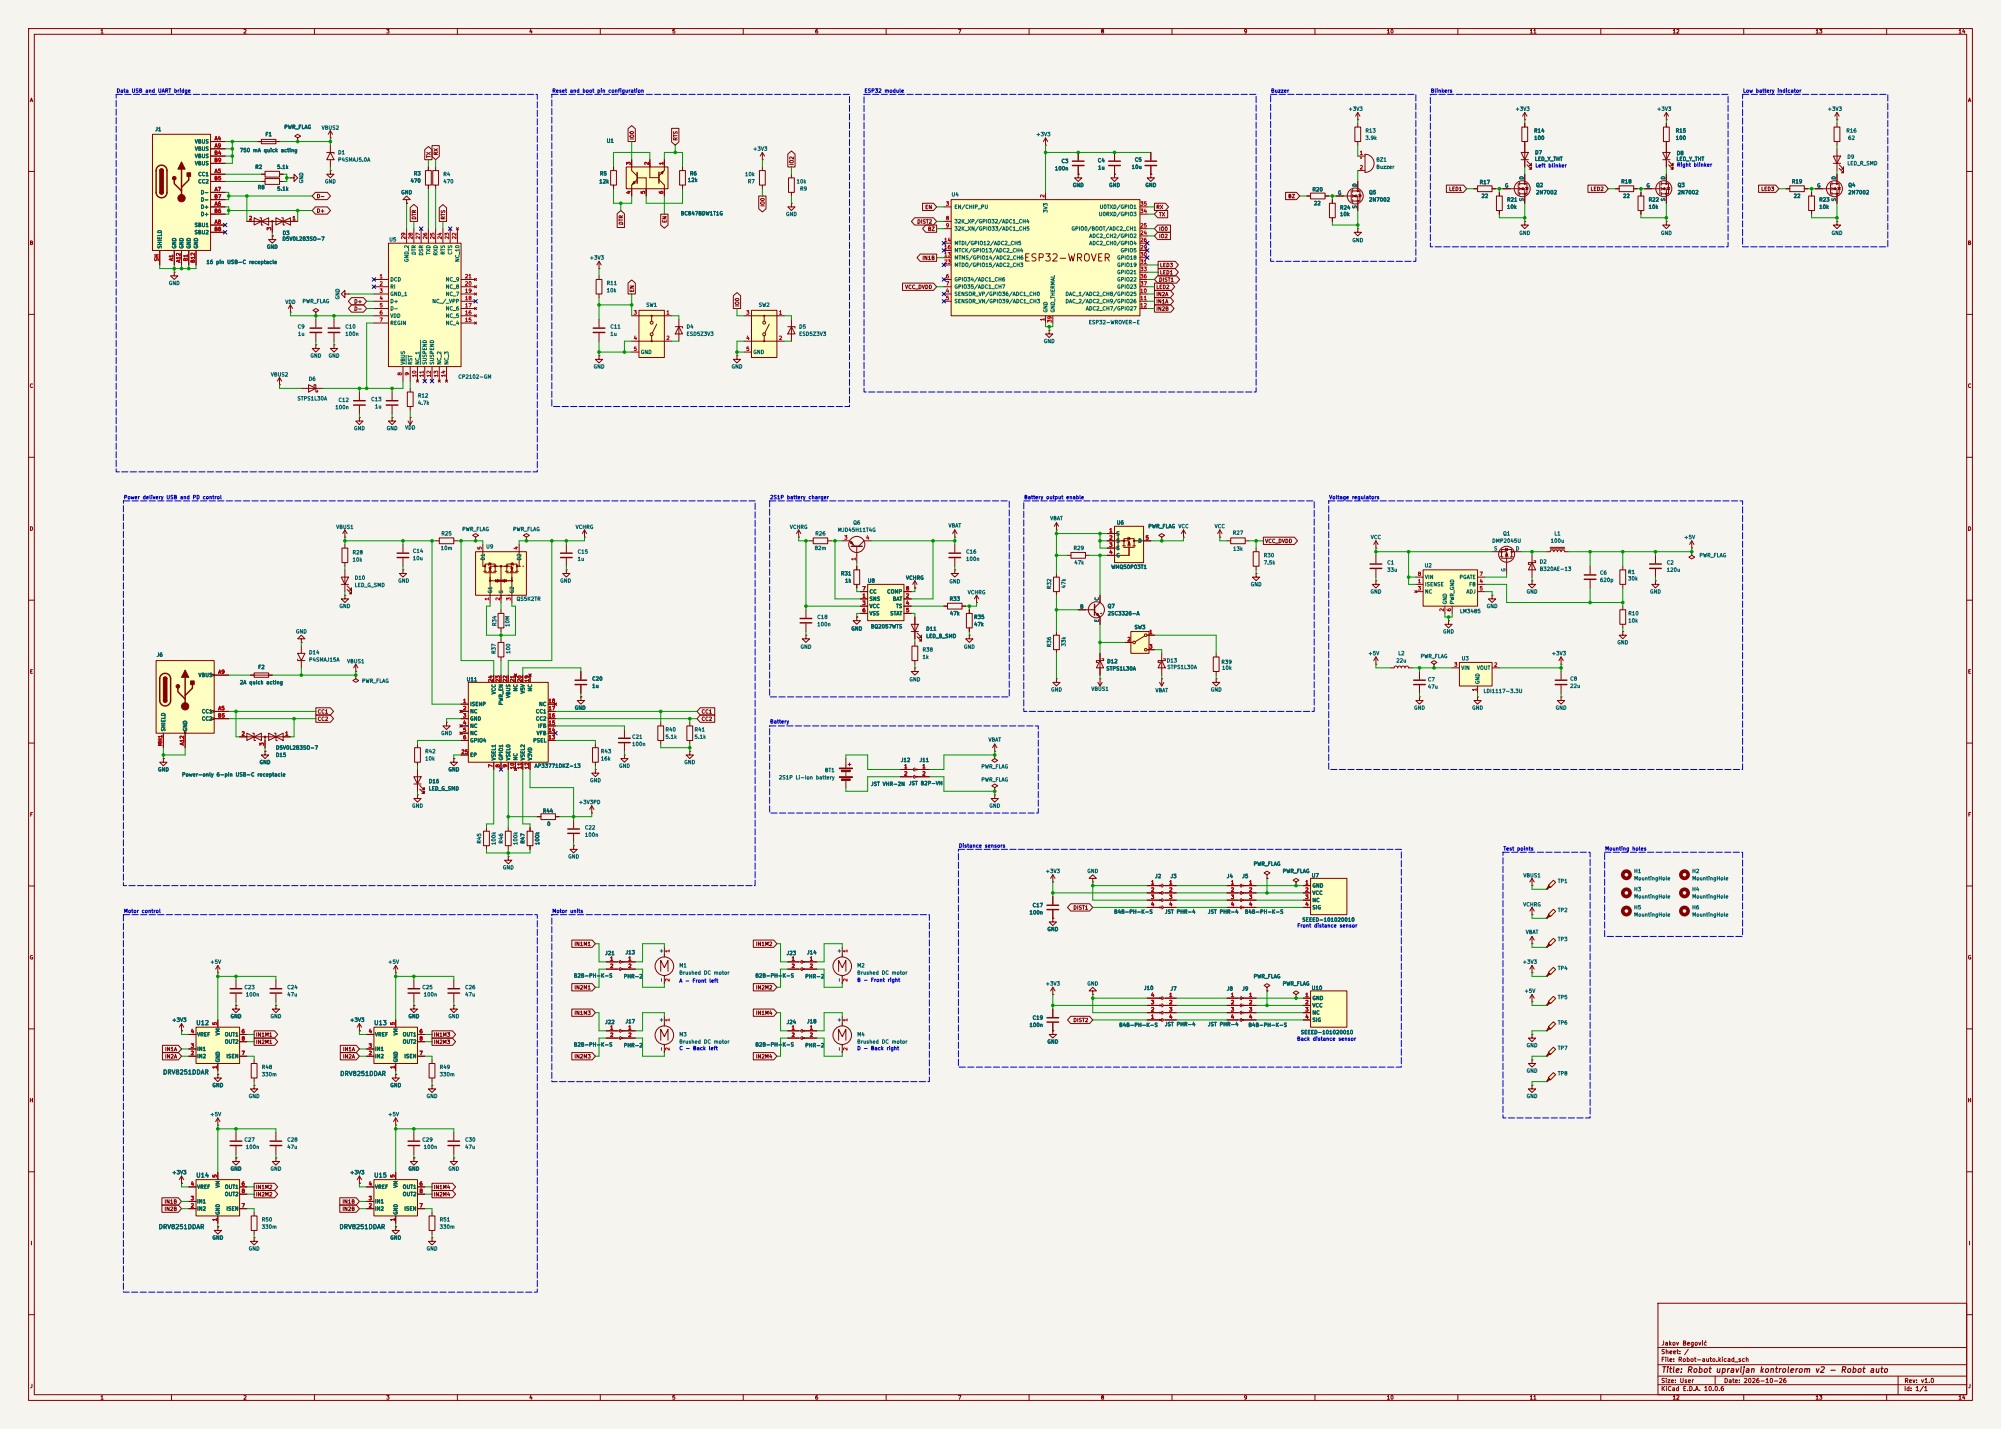
[picture p10: page 1]

Left blinker Data USB and UART bridge

16 pin USB-C receptacle GND GND

16 pin USB-C receptacle GND A1

Power delivery USB and PD control

9 NC 10 VSEL2 11 V3VD 12 PSEL 13 VFB 14 IFB 15 CC2 16 CC1 17 NC 18 NC 19 V5V 20 NC 21 VBUS 22 VCC 24

Distance sensors B - Front right

A - Front left Motor control

Jakov Begović
Sheet: /
File: Robot-auto.kicad_sch
Title: Robot upravljan kontrolerom v2 - Robot auto

Size: User | Rev: v1.0
KiCad E.D.A. 10.0.6 | Id: 1/1
