JakovBegovic/Robot-upravljan-kontrolerom-v2/Električne sheme/Robot-auto/Robot-auto.kicad_pcb

## KiCad design Električne sheme/Robot-auto/Robot-auto.kicad_pcb (2026-11-09)

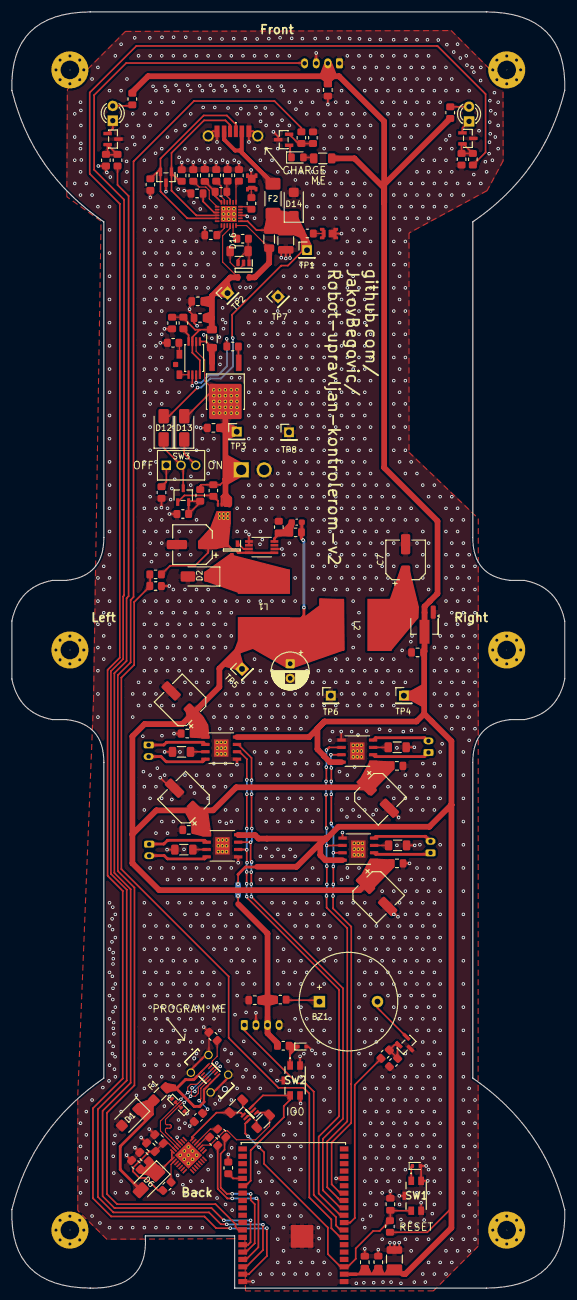
[picture p11: board Robot-auto.kicad_pcb from above]

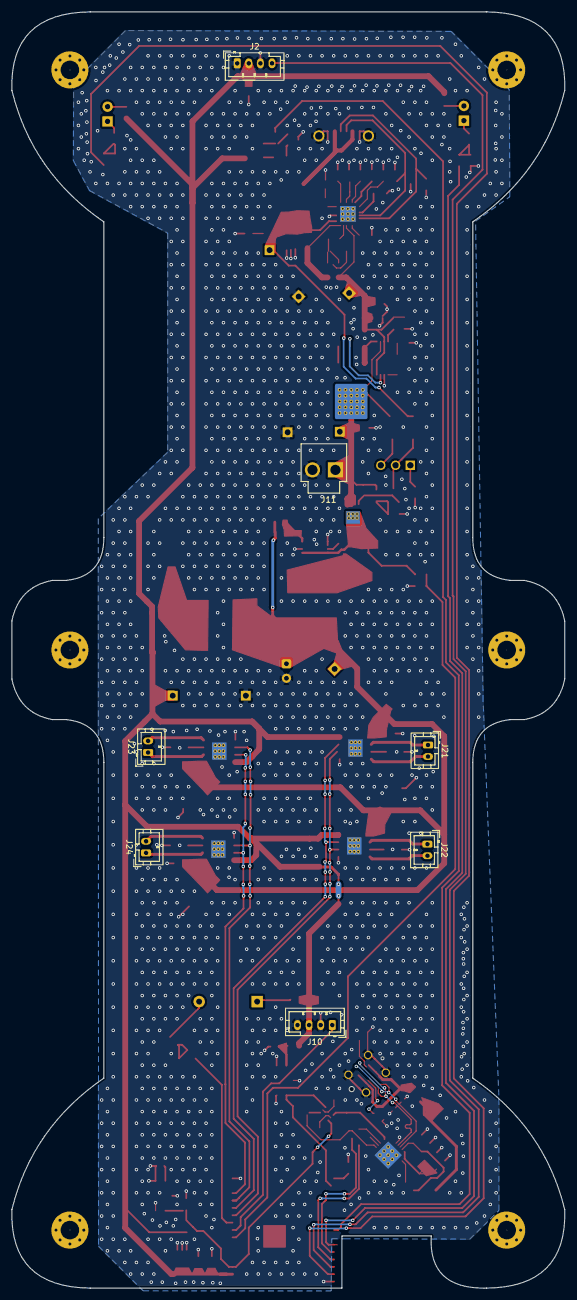
[picture p12: board Robot-auto.kicad_pcb from below]

Board: 2 copper layers, 95.3 x 220.0 mm, 149 parts (7 on the bottom side), 94 nets.

Parts:
BZ1: Buzzer; LD-BZPN-1705
C1: 33u; CP_Elec_6.3x7.7
C2: 120u; CP_Radial_D6.3mm_P2.50mm
C3, C10, C12, C16, C17, C18, C19, C21, C22, C23, C25, C27, C29: 100n; C_0805_2012Metric_Pad1.18x1.45mm_HandSolder
C4, C9, C11, C13, C15, C20: 1u; C_0805_2012Metric_Pad1.18x1.45mm_HandSolder
C5, C14: 10u; C_1210_3225Metric_Pad1.33x2.70mm_HandSolder
C6: 620p; C_0603_1608Metric_Pad1.08x0.95mm_HandSolder
C7, C24, C26, C28, C30: 47u; CP_Elec_6.3x7.7
C8: 22u; C_0805_2012Metric_Pad1.18x1.45mm_HandSolder
D1: P4SMAJ5.0A; P25_DO-214AC_SMA
D2: B320AE-13; D_SMA
D3, D17: STN101033B101; D_SOD-882D
D4, D5: ESD5Z3V3; D_SOD-523
D6, D12, D13: STPS1L30A; D_SMA
D7, D8: LED_Y_THT; LED_D3.0mm_Clear
D9: LED_R_SMD; LED_0805_2012Metric_Pad1.15x1.40mm_HandSolder
D10, D16: LED_G_SMD; N0G20S39
D11: LED_B_SMD; LED_SMD_1204
D14: P4SMAJ15A; P25_DO-214AC_SMA
D15: D5V0L2B3SO-7; SOT-23_editable
F1: 750 mA quick acting; Fuse_1206_3216Metric_Pad1.42x1.75mm_HandSolder
F2: 2A quick acting; 0679L2000-01_BEL-XL
H1, H2, H3, H4, H5, H6: MountingHole; MountingHole_3.2mm_M3_Pad_Via
J1: 16 pin USB-C receptacle; USB412003C
J2, J10: B4B-PH-K-S; JST_PH_B4B-PH-K_1x04_P2.00mm_Vertical
J6: Power-only 6-pin USB-C receptacle; USB4130GFC
J11: JST B2P-VH; JST_B2P-VH
J21, J22, J23, J24: B2B-PH-K-S; JST_PH_B2B-PH-K_1x02_P2.00mm_Vertical
L1: 100u; JNRH-1207-101M-A
L2: 22u; JNRH-1207-101M-A
Q1: DMP2045U; SOT23_3-pin
Q2, Q3, Q4, Q5: 2N7002; SOT-23_editable
Q6: MJD45H11T4G; TO229P990X238-3N
Q7: 2SC3326-A; S-MINI_TOS-M
R1: 30k; R_0805_2012Metric_Pad1.20x1.40mm_HandSolder
R2, R8, R40, R41: 5.1k; R_0805_2012Metric_Pad1.20x1.40mm_HandSolder_editable
R3, R4: 470; R_0805_2012Metric_Pad1.20x1.40mm_HandSolder
R5, R6: 12k; R_1206_3216Metric_Pad1.30x1.75mm_HandSolder
R7, R9, R10, R11, R21, R22, R23, R24, R28, R39, R42: 10k; R_0805_2012Metric_Pad1.20x1.40mm_HandSolder_editable
R12: 4.7k; R_0805_2012Metric_Pad1.20x1.40mm_HandSolder
R13: 3.9k; R_0805_2012Metric_Pad1.20x1.40mm_HandSolder_editable
R14, R15, R37: 100; R_0805_2012Metric_Pad1.20x1.40mm_HandSolder_editable
R16: 62; R_1206_3216Metric_Pad1.30x1.75mm_HandSolder
R17, R18, R19, R20: 22; R_0805_2012Metric_Pad1.20x1.40mm_HandSolder_editable
R25: 10m; R_1206_3216Metric_Pad1.30x1.75mm_HandSolder
R26: 82m; R_1206_3216Metric_Pad1.30x1.75mm_HandSolder
R27: 13k; R_0805_2012Metric_Pad1.20x1.40mm_HandSolder
R29, R32, R33, R35: 47k; R_0805_2012Metric_Pad1.20x1.40mm_HandSolder_editable
R30: 7.5k; R_0805_2012Metric_Pad1.20x1.40mm_HandSolder
R31, R38: 1k; R_0805_2012Metric_Pad1.20x1.40mm_HandSolder_editable
R34: 10M; R_1206_3216Metric_Pad1.30x1.75mm_HandSolder
R36: 33k; R_0805_2012Metric_Pad1.20x1.40mm_HandSolder
R43: 16k; R_0805_2012Metric_Pad1.20x1.40mm_HandSolder_editable
R44: 0; R_0805_2012Metric_Pad1.20x1.40mm_HandSolder_editable
R45, R46, R47: 100k; R_0805_2012Metric_Pad1.20x1.40mm_HandSolder_editable
R48, R49, R50, R51: 330m; R_1206_3216Metric_Pad1.30x1.75mm_HandSolder
SW1, SW2: EVQP2F02K
SW3: 200MSP1T2B4M2QE; SW_200MSP1T2B4M2QE
TP1, TP2, TP3, TP4, TP5, TP6, TP7, TP8: TestPoint_Probe; PinHeader_1x01_P2.54mm_Vertical
U1: BC847BDW1T1G
U2: LM3485
U3: LDI1117-3.3U; SOT-89-3_Handsoldering
U4: ESP32-WROVER-E
U5: CP2102-GM; QFN50P500X500X100-29N-D
U6: WMQ50P03T1; PDFN3030-8L
U8: BQ2057WTS; TSSOP-8_4.4x3mm_P0.65mm_editable
U9: QS5K2TR; SOT95P280X100-5N
U11: AP33771DKZ-13; W-QFN4040-24_ThermalVias
U12, U13, U14, U15: DRV8251DDAR; POWERPAD_DDA_TEX

Connections:
+3V3: C3.1, C4.1, C5.1, C8.1, C17.1, C19.1, J2.2, J10.3, R7.1, R11.2, R13.1, R14.1, R15.1, R16.1, TP4.1 (1_1), U3.2 (VOUT), U4.2 (3V3), U12.4 (VREF), U13.4 (VREF), U14.4 (VREF), U15.4 (VREF)
+3V3PD: C22.1, R44.2, U11.12 (V3VD)
+5V: C2.1, C6.1, C23.2, C24.1, C25.2, C26.1, C27.2, C28.1, C29.2, C30.1, L1.2, L2.1, R1.2, TP5.1 (1_1), U12.5 (VM), U13.5 (VM), U14.5 (VM), U15.5 (VM)
BZ: R20.1, U4.9 (32K_XN/GPIO33/ADC1_CH5)
CC1: D15.2 (A2), J6.A5 (CC1), R40.2, U11.17 (CC1)
CC2: D15.1 (A1), J6.B5 (CC2), R41.2, U11.16 (CC2)
D+: D17.2 (A2), J1.A6 (D+), J1.B6 (D+), U5.4 (D+)
D-: D3.2 (A2), J1.A7 (D-), J1.B7 (D-), U5.5 (D-)
DIST1: J2.4, U4.36 (GPIO22)
DIST2: J10.1, U4.8 (32K_XP/GPIO32/ADC1_CH4)
DTR: R5.2, U1.4 (E1), U5.28 (DTR)
EN: C11.1, D4.1 (K), R11.1, SW1.1, SW1.3, U1.6 (C2), U4.3 (EN/CHIP_PU)
GND: C1.2, C2.2, C3.2, C4.2, C5.2, C7.2, C8.2, C9.2, C10.2, C11.2, C12.2, C13.2, C14.2, C15.2, C16.2, C17.2, C18.2, C19.2, C20.2, C21.2, C22.2, C23.1, C24.2, C25.1, C26.2, C27.1, C28.2, C29.1, C30.2, D1.2 (A2), D2.2 (A), D3.1 (A1), D4.2 (A), D5.2 (A), D10.1 (K), D14.2 (A2), D15.3 (common), D16.1 (K), D17.1 (A1), J1.A1 (GND), J1.A12 (GND), J1.B1 (GND), J1.B12 (GND), J1.SH (SHIELD), J2.1, J2.3, J6.A12 (GND), J6.B12 (GND), J6.MH1 (SHIELD), J6.MH2 (SHIELD), J10.2, J10.4, J11.2, Q2.3 (S), Q3.3 (S), Q4.3 (S), Q5.3 (S), R2.1, R8.2, R9.1, R10.2, R21.2, R22.2, R23.1, R24.2, R30.1, R35.1, R36.2, R38.2, R39.2, R40.1, R41.1, R43.1, R45.2, R46.2, R47.2, R48.2, R49.2, R50.2, R51.2, SW1.2, SW1.4, SW1.5 (GND_5), SW2.2, SW2.4, SW2.5 (GND_5), TP6.1 (1_1), TP7.1 (1_1), TP8.1 (1_1), U2.2 (GND), U2.5 (ADJ), U2.6 (PWR_GND), U3.1 (GND), U4.1 (GND), U4.15 (GND), U4.38 (GND), U4.39 (GND_THERMAL), U5.3 (GND_1), U5.29 (GND_2), U8.6 (VSS), U11.3 (GND), U11.25 (EP), U12.1 (GND), U12.9 (EP), U13.1 (GND), U13.9 (EP), U14.1 (GND), U14.9 (EP), U15.1 (GND), U15.9 (EP)
IN1A: U4.11 (DAC_2/ADC2_CH9/GPIO26), U12.3 (IN1), U13.3 (IN1)
IN1B: U4.13 (MTMS/GPIO14/ADC2_CH6), U14.3 (IN1), U15.3 (IN1)
IN1M1: J21.1, U12.6 (OUT1)
IN1M2: J23.1, U14.6 (OUT1)
IN1M3: J22.1, U13.6 (OUT1)
IN1M4: J24.1, U15.6 (OUT1)
IN2A: U4.10 (DAC_1/ADC2_CH8/GPIO25), U12.2 (IN2), U13.2 (IN2)
IN2B: U4.12 (ADC2_CH7/GPIO27), U14.2 (IN2), U15.2 (IN2)
IN2M1: J21.2, U12.8 (OUT2)
IN2M2: J23.2, U14.8 (OUT2)
IN2M3: J22.2, U13.8 (OUT2)
IN2M4: J24.2, U15.8 (OUT2)
IO0: D5.1 (K), R7.2, SW2.1, SW2.3, U1.3 (C1), U4.25 (GPIO0/BOOT/ADC2_CH1)
IO2: R9.2, U4.24 (ADC2_CH2/GPIO2)
LED1: R17.1, U4.33 (GPIO21)
LED2: R18.1, U4.37 (GPIO23)
LED3: R19.2, U4.31 (GPIO19)
unnamed: BZ1.1 (+), R13.2
unnamed: BZ1.2 (-), Q5.1 (D)
unnamed: D2.1 (K), L1.1, Q1.3 (D)
unnamed: C12.1, C13.1, D6.1 (K), U5.7 (REGIN), U5.8 (VBUS)
unnamed: D7.2 (A), R14.2
unnamed: D7.1 (K), Q2.1 (D)
unnamed: D8.2 (A), R15.2
unnamed: D8.1 (K), Q3.1 (D)
unnamed: D9.2 (A), R16.2
unnamed: D9.1 (K), Q4.1 (D)
unnamed: D10.2 (A), R28.2
unnamed: D11.2 (A), U8.5 (STAT)
unnamed: D11.1 (K), R38.1
unnamed: D12.1 (K), Q7.3 (E), SW3.2 (B)
unnamed: D13.1 (K), SW3.3 (C)
unnamed: D16.2 (A), R42.1
unnamed: F1.1, J1.A4 (VBUS), J1.A9 (VBUS), J1.B4 (VBUS), J1.B9 (VBUS)
unnamed: F2.1, J6.A9 (VBUS), J6.B9 (VBUS)
unnamed: J1.A5 (CC1), R2.2
unnamed: J1.B5 (CC2), R8.1
unnamed: Q1.1 (G), U2.7 (PGATE)
unnamed: Q2.2 (G), R17.2, R21.1
unnamed: Q3.2 (G), R18.2, R22.1
unnamed: Q4.2 (G), R19.1, R23.2
unnamed: Q5.2 (G), R20.2, R24.1
unnamed: Q6.1 (B), R31.1
unnamed: Q6.3 (E), R26.2, U8.1 (SNS)
unnamed: Q7.2 (B), R32.2, R36.1
unnamed: Q7.1 (C), R29.1, U6.4 (G)
unnamed: R39.1, SW3.1 (A)
unnamed: R6.2, U1.5 (B1)
unnamed: R5.1, U1.2 (B2)
unnamed: C6.2, R1.1, R10.1, U2.4 (FB)
unnamed: C7.1, L2.2, U3.3 (VIN)
unnamed: R4.2, U5.25 (RXD)
unnamed: R3.2, U5.26 (TXD)
unnamed: R12.1, U5.9 (~RST)
unnamed: R31.2, U8.7 (CC)
unnamed: R33.1, U8.4 (TS)
unnamed: R34.1, R37.2, U9.1 (G1), U9.3 (G2)
unnamed: R34.2, U9.2 (S)
unnamed: R42.2, U11.6 (GPIO4)
unnamed: C21.1, U11.15 (IFB)
unnamed: R43.2, U11.13 (PSEL)
unnamed: R37.1, U11.23 (PWR_EN)
unnamed: C20.1, U11.20 (V5V)
unnamed: R25.2, U9.5 (D1), U11.24 (VCC)
unnamed: R44.1, R46.1, U11.9 (VSEL0)
unnamed: R45.1, U11.7 (VSEL1)
unnamed: R47.1, U11.11 (VSEL2)
unnamed: R48.1, U12.7 (ISEN)
unnamed: R49.1, U13.7 (ISEN)
unnamed: R50.1, U14.7 (ISEN)
unnamed: R51.1, U15.7 (ISEN)
RTS: R6.1, U1.1 (E2), U5.24 (RTS)
RX: R4.1, U4.35 (U0TXD/GPIO1)
TX: R3.1, U4.34 (U0RXD/GPIO3)
VBAT: C16.1, D13.2 (A), J11.1, Q6.4 (C), R29.2, R32.1, TP3.1 (1_1), U6.1 (S), U6.2 (S), U6.3 (S), U8.2 (BAT)
VBUS1: C14.1, D12.2 (A), D14.1 (A1), F2.2, R25.1, R28.1, TP1.1 (1_1), U11.1 (ISENP)
VBUS2: D1.1 (A1), D6.2 (A), F1.2
VCC: C1.1, Q1.2 (S), R27.1, U2.1 (ISENSE), U2.8 (VIN), U6.5 (D)
VCC_DVDD: R27.2, R30.2, U4.7 (GPIO35/ADC1_CH7)
VCHRG: C15.1, C18.1, R26.1, R33.2, R35.2, TP2.1 (1_1), U8.3 (VCC), U8.8 (COMP), U9.4 (D2), U11.22 (VBUS)
VDD: C9.1, C10.1, R12.2, U5.6 (VDD)
