JakovBegovic/Robot-upravljan-kontrolerom-v2/Električne sheme/Kontroler/Kontroler.kicad_pcb

## KiCad design Električne sheme/Kontroler/Kontroler.kicad_pcb (2026-11-08)

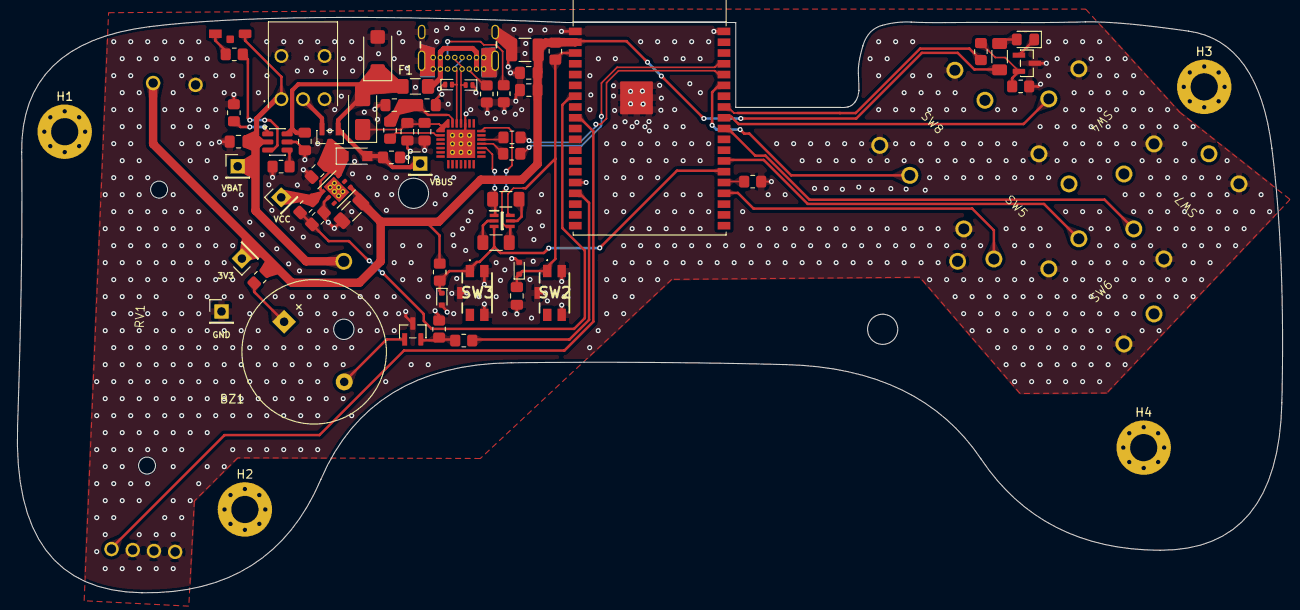
[picture p13: board Kontroler.kicad_pcb from above]

Board: 2 copper layers, 148.9 x 67.7 mm, 73 parts (1 on the bottom side), 44 nets.

Parts:
BT1: 1S1P Li-Ion battery; 1043P
BZ1: Buzzer; LD-BZPN-1705
C1, C4, C5, C6, C7, C8, C11: 1u; C_0805_2012Metric_Pad1.18x1.45mm_HandSolder
C2, C3, C10: 100n; C_0805_2012Metric_Pad1.18x1.45mm_HandSolder
C9: 22u; C_1206_3216Metric_Pad1.33x1.80mm_HandSolder
C12: 10u; C_1210_3225Metric_Pad1.33x2.70mm_HandSolder
D2: PMEG3010BER; Nexperia_CFP3_SOD-123W
D3: STPS1L30A; D_SMA
D4: P4SMAJ5.0A; P25_DO-214AC_SMA
D5, D6: ESD5Z3V3; D_SOD-523
D7: LED_R_SMD; LED_0805_2012Metric_Pad1.15x1.40mm_HandSolder
D8: LED_B_SMD; LED_SMD_1204
D9, D17: STN101033B101; D_SOD-882D
F1: 1.2A quick acting; Fuse_1206_3216Metric_Pad1.42x1.75mm_HandSolder
H1, H2, H3, H4: MountingHole; MountingHole_3.2mm_M3_Pad_Via
J1: USB4920; GCT_USB4920-00-A_REVA
Q1: MMFTP3401; SOT-23_editable
Q2, Q3: 2N7002; SOT-23_editable
R1, R2: 5.1k; R_0805_2012Metric_Pad1.20x1.40mm_HandSolder_editable
R3: 100k; R_0805_2012Metric_Pad1.20x1.40mm_HandSolder_editable
R4: 4.7k; R_0805_2012Metric_Pad1.20x1.40mm_HandSolder
R5, R6: 470; R_0805_2012Metric_Pad1.20x1.40mm_HandSolder
R7: 1.2k; R_0805_2012Metric_Pad1.20x1.40mm_HandSolder
R8, R9, R14, R15, R17, R20: 10k; R_0805_2012Metric_Pad1.20x1.40mm_HandSolder_editable
R10, R13: 12k; R_1206_3216Metric_Pad1.30x1.75mm_HandSolder
R11, R12, R22: 1k; R_0805_2012Metric_Pad1.20x1.40mm_HandSolder_editable
R16, R19: 22; R_0805_2012Metric_Pad1.20x1.40mm_HandSolder_editable
R18: 62; R_1206_3216Metric_Pad1.30x1.75mm_HandSolder
R21: 3.9k; R_0805_2012Metric_Pad1.20x1.40mm_HandSolder_editable
RV1: RS45112A400G
SW1: 200MSP1T1B2M6QE
SW2, SW3: EVQP2F02K
SW4, SW5, SW6, SW7, SW8: TACTS-24K-F
TP1, TP2, TP3, TP4, TP5: TestPoint_Probe; PinHeader_1x01_P2.54mm_Vertical
U1: CP2102-GM; QFN50P500X500X100-29N-D
U2: BQ21040DBVR; SOT-23-6
U3: BC847BDW1T1G
U4: LD39100PU33R; DFN-6-editable
U5: ESP32-WROVER-E

Connections:
+3V3: C9.1, C10.1, C11.1, C12.1, R9.2, R14.1, R18.1, R21.1, RV1.3, TP3.1 (1_1), U4.4 (VOUT), U5.2 (3V3)
BZ: R19.1, U5.16 (MTCK/GPIO13/ADC2_CH4)
D+: D17.2 (A2), J1.A6 (D+), J1.B6 (D+), U1.4 (D+)
D-: D9.2 (A2), J1.A7 (D-), J1.B7 (D-), U1.5 (D-)
DTR: R10.2, U1.28 (DTR), U3.4 (E1)
EN: C7.1, D5.1 (K), R9.1, SW2.1, SW2.3, U3.6 (C2), U5.3 (EN/CHIP_PU)
GND: BT1.2 (-), C1.2, C2.2, C3.2, C4.2, C5.2, C6.2, C7.2, C8.2, C9.2, C10.2, C11.2, C12.2, D4.2 (A2), D5.2 (A), D6.2 (A), D9.1 (A1), D17.1 (A1), J1.A1 (GND), J1.A12 (GND), J1.B1 (GND), J1.B12 (GND), J1.SH1 (SHIELD), J1.SH2 (SHIELD), J1.SH3 (SHIELD), J1.SH4 (SHIELD), Q2.3 (S), Q3.3 (S), R1.1, R2.2, R3.2, R7.2, R8.1, R12.2, R15.1, R17.1, R20.2, RV1.2, RV1.4, RV1.5, RV1.6, SW1.3 (C), SW1.MH1, SW1.MH2, SW2.2, SW2.4, SW2.5 (GND_5), SW3.2, SW3.4, SW3.5 (GND_5), SW4.1, SW4.3, SW5.1, SW5.3, SW6.1, SW6.3, SW7.1, SW7.3, SW8.1, SW8.3, TP5.1 (1_1), U1.3 (GND_1), U1.29 (GND_2), U2.5 (GND), U4.2 (GND), U4.7 (GND), U5.1 (GND), U5.15 (GND), U5.38 (GND), U5.39 (GND_THERMAL)
IO0: D6.1 (K), R14.2, SW3.1, SW3.3, U3.3 (C1), U5.25 (GPIO0/BOOT/ADC2_CH1)
IO2: R15.2, U5.24 (ADC2_CH2/GPIO2)
LEDR: R16.2, U5.31 (GPIO19)
unnamed: BZ1.1 (+), R21.2
unnamed: BZ1.2 (-), Q3.1 (D)
unnamed: C3.1, C4.1, D3.1 (K), U1.7 (REGIN), U1.8 (VBUS)
unnamed: D7.2 (A), R18.2
unnamed: D7.1 (K), Q2.1 (D)
unnamed: D8.1 (K), R22.1
unnamed: F1.1, J1.A4 (VBUS), J1.A9 (VBUS), J1.B4 (VBUS), J1.B9 (VBUS)
unnamed: J1.A5 (CC1), R1.2
unnamed: J1.B5 (CC2), R2.1
unnamed: Q1.2 (S), SW1.2 (B)
unnamed: Q2.2 (G), R16.1, R17.2
unnamed: Q3.2 (G), R19.2, R20.1
unnamed: R6.2, U1.25 (RXD)
unnamed: R5.2, U1.26 (TXD)
unnamed: R4.1, U1.9 (~RST)
unnamed: R7.1, U2.4 (ISET)
unnamed: R8.2, U2.1 (TS)
unnamed: R13.2, U3.5 (B1)
unnamed: R10.1, U3.2 (B2)
RTS: R13.1, U1.24 (RTS), U3.1 (E2)
RV1: RV1.1, U5.9 (32K_XN/GPIO33/ADC1_CH5)
RX: R6.1, U5.35 (U0TXD/GPIO1)
SW1: SW4.2, SW4.4, U5.30 (GPIO18)
SW2: SW5.2, SW5.4, U5.23 (MTDO/GPIO15/ADC2_CH3)
SW3: SW6.2, SW6.4, U5.26 (ADC2_CH0/GPIO4)
SW4: SW7.2, SW7.4, U5.29 (GPIO5)
SW5: SW8.2, SW8.4, U5.33 (GPIO21)
TX: R5.1, U5.34 (U0RXD/GPIO3)
VBAT: BT1.1 (+), C6.1, D8.2 (A), SW1.1 (A), TP2.1 (1_1), U2.2 (OUT)
VBUS: C5.1, D2.2 (A), D3.2 (A), D4.1 (A1), F1.2, Q1.1 (G), R3.1, TP1.1 (1_1), U2.6 (VIN)
VCC: C8.1, D2.1 (K), Q1.3 (D), R11.1, TP4.1 (1_1), U4.1 (EN), U4.6 (VIN)
VCC_DVDD: R11.2, R12.1, U5.7 (GPIO35/ADC1_CH7)
VDD: C1.1, C2.1, R4.2, U1.6 (VDD)
~CHG: R22.2, U2.3 (~CHG)
