JakovBegovic/Robot-upravljan-kontrolerom-v2/Programski kod/Kontroler/src/HrdwrController.cpp

#include "HrdwrController.h"

namespace
{
    /*
    *   HrdwrController private variables
    */
    const uint8_t buzzerPIN = 25;
    const uint8_t rLedPIN = 19;
    const uint8_t gLedPIN = 18;

    const float maxBttryVoltage = 4.25f;
    const float requestChargingTreshold = 3.2f;
    const float minBttryVoltage = 3.1f; // +100 mV for tolerance

    uint8_t songPlaying = 0;

    QueueHandle_t musicQueue = NULL;


    /*
    *   HrdwrController private functions
    */

    void pauseMusic()
    {
        vTaskSuspend( Tasker::getMusicTaskHandle() );
    }

    void resumeMusic()
    {
        vTaskResume( Tasker::getMusicTaskHandle() );
    }

    bool musicIsPaused()
    {
        return eTaskGetState( Tasker::getMusicTaskHandle() ) == eSuspended;
    }

    void playNextSong()
    {
        songPlaying = ( songPlaying + 1 ) % songsCount ;

        xQueueSend( musicQueue, &songPlaying, 0 );

        if( musicIsPaused() )
        {
            resumeMusic();
        }
    }


}


/*
*   HrdwrController public function definitions
*/

void HrdwrController::setup()
{
    pinMode( buzzerPIN, OUTPUT );
    pinMode( rLedPIN, OUTPUT );
    pinMode( gLedPIN, OUTPUT );

    musicQueue = xQueueCreate( 5, sizeof( uint8_t ) );
}

void HrdwrController::monitorBttryTask( void *pvParamater )
{
    while( 1 )
    {
        float vBat = HrdwrReader::readBttryVoltage();
        Serial.println( vBat );

        if( vBat >= maxBttryVoltage )
        {
            digitalWrite( gLedPIN, HIGH );
        }
        else if ( vBat <= minBttryVoltage )
        {
            digitalWrite( rLedPIN, HIGH );
        }
        else
        {
            digitalWrite( gLedPIN, LOW );
            digitalWrite( rLedPIN, LOW );
        }

        vTaskDelay( 500 / portTICK_PERIOD_MS );
    }
}

void HrdwrController::playSongTask( void *pvParameter )
{
    uint8_t songNum = 0;

    while( true )
    {
        int tempo = songs[ songNum ].tempo;
        int notes = songs[ songNum ].length / 2;
        int wholenote = ( 60000 * 4 ) / tempo; // in ms
        int divider = 0, noteDuration = 0;

        for ( int thisNote = 0; thisNote < notes * 2; thisNote = thisNote + 2 )
        {
            if( xQueueReceive( musicQueue, &songNum, 0 ) != errQUEUE_EMPTY )
            {
                break;
            }

            divider = songs[ songNum ].data[ thisNote + 1 ];

            if ( divider > 0 )
            {
                noteDuration = ( wholenote ) / divider;
            }
            else if ( divider < 0 )
            {
                // dotted notes are represented with negative durations
                noteDuration = ( wholenote ) / abs( divider );
                noteDuration *= 1.5; // increases the duration for dotted notes
            }

            // play the note for 90% of the duration
            tone( buzzerPIN, songs[ songNum ].data[ thisNote ], noteDuration * 0.9 );
            vTaskDelay( noteDuration / portTICK_PERIOD_MS );

            // stop the waveform generation before the next note.
            noTone( buzzerPIN );
        }
    }
}

void HrdwrController::musicCtrlTask( void *pvParameter )
{
    bool isMusicBtnPressed = false;
    uint16_t pressedInRow = 0;

    while( true )
    {
        isMusicBtnPressed = HrdwrReader::readMusicBtn();

        if( isMusicBtnPressed )
        {
            pressedInRow++;

            if( pressedInRow == 25 )
            {
                pauseMusic();
            }
        }
        else
        {
            if( pressedInRow > 0
                &&
                pressedInRow < 15
              )
            {
                if( musicIsPaused() )
                {
                    resumeMusic();
                }
                else
                {
                    playNextSong();
                }
            }

            pressedInRow = 0;
        }

        vTaskDelay( 75 / portTICK_PERIOD_MS );
    }
}
