JakovBegovic/Robot-upravljan-kontrolerom-v2/Programski kod/Kontroler/include/HardwareReader.h

#pragma once
#include "HrdwrController.h"
#include <Arduino.h>

namespace HardwareReader
{
    /*
    *   HardwareReader public functions
    */

    /**
     * @brief   Setup communication with hardware pheripherals
     */
    void setup();

    /**
    * @brief    Get user command on move direction
     *
     * @return
     *          1 : forward
     *          0 : stop frontal movement
     *          -1 : backward
    */
    int8_t getMoveDir();

    /**
     * @brief   Get user command on rotation
     *
     * @return
     *          1 : right
     *          0 : stop rotation
     *          -1 : left
     */
    int8_t getRotation();

    /**
    * @brief    Get user command on speed
     *
     * @return
     *          0 to 4095
    */
    uint16_t getSpeed();
};
