JakovBegovic/Robot-upravljan-kontrolerom-v2/Programski kod/Robot-auto/include/msgStruct.h

#pragma once
#include <Arduino.h>

struct msgStruct
{
    // 0 stop, 1 forward, -1 backward
    int8_t moveDirection;

    // 0 no rotation, 1 right, -1 left
    int8_t rotation;

    // 0 to 4095
    uint16_t speed;
};

bool operator!=( const msgStruct& a, const msgStruct& b );

bool areSpeedsMatching( uint16_t speed1, uint16_t speed2, uint16_t interval );

void copyMsg( msgStruct& from, msgStruct& to );
