JakovBegovic/Robot-upravljan-kontrolerom-v2/(commit log)

2025-11-20 Omogućio uključivanje i gašenje LED diode.
2025-11-23 Omogućio paljenje LE diode koja korespondira poslijednjoj poslanoj poruci.
2025-11-23 Učahurio logiku upravljanja LED-icama u zasebnu funkciju.
2025-11-28 Izradio novi KiCad projekt koji opisuje električnu shemu kontrolera.
    [Kontroler.kicad_pcb, Kontroler.kicad_sch]
2025-11-30 Dodao datoteku električne sheme kontrolera.
    [Kontroler.kicad_pcb, Kontroler.kicad_sch]
2025-11-30 Napravio novi KiCad projekt za električnu shemu robot auta.
    [Robot-auto.kicad_pcb, Robot-auto.kicad_sch]
2025-11-30 Nacrtao električnu šemu za robot-auto.
    [Robot-auto.kicad_sch]
2025-12-01 U šemu dodao prekidač za gašenje i paljenje mikroupravljača kontrolera.
    Ulazni pin RESET razvojne pločice se povezuje na ulazni pin EN mikroupravljača. Mikroupravljač je omogućen za EN = HIGH.
    [Kontroler.kicad_sch]
2025-12-01 U šemu dodao prekidač za gašenje i paljenje mikroupravljača robot-auta.
    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
    [Robot-auto.kicad_sch]
2025-12-02 Omogućio postavljanje LED-ica na zadanu vrijednost 0 u slučaju da niti jedna poruka nije dobivena unutar posljednjih 750 milisekundi.
2025-12-03 Izbjegao okidanje watchdog timera na neuspješno slanje paketa i iskoristio ACK poruku koja je slana od primatelja za potvrdu uspješno poslanog paketa.
2025-12-03 Dodao potenciometar u električnu shemu kontrolera.
    [Kontroler.kicad_sch]
2025-12-03 Uredio električnu šemu robot-auta.
    [Robot-auto.kicad_sch]
2025-12-15 Promijenio šemu kontrolera kako bi pravilno prikazivala broj pina na koji je spojen potenciometar.
    [Kontroler.kicad_sch]
2025-12-15 Privremene lokalne datoteke dodao u .gitignore.
    Datoteke koje KiCAD koristi kada se uređuje jedna od šema.
2025-12-16 Varijablu failedMsgsInARow premjestio u klasu.
    [CommsController.h, main.cpp]
2025-12-22 Definirao električnu shemu robot-auta.
    [Robot-auto.kicad_sch]
2025-12-22 Dodao motore u električnu shemu robot-auta.
    [Robot-auto.kicad_sch]
2025-12-22 Doradio pozicije električnih komponenti u shemi.
    [Robot-auto.kicad_sch]
2025-12-22 Doradio električnu shemu kontrolera.
    Dodao zujalicu i bateriju.
    [Kontroler.kicad_sch]
2025-12-22 Grupirao dijelove sheme. Dodao ulaz za čitanje naponske razine baterije.
    [Robot-auto.kicad_sch]
2025-12-22 Dodao indikatore za punjenje.
    [Kontroler.kicad_sch]
2025-12-22 Na šemi robot-auta dodao prekidač za uklapanje i isklapanje napajanja i oduzeo jedan naponski izvor iz šeme.
    [Robot-auto.kicad_sch]
2025-12-22 Shemama dodao verziju.
    [Kontroler.kicad_sch, Robot-auto.kicad_sch]
2025-12-22 Promijenio pin-ove LE-dioda kako bi odgovarali onima na novo električnoj shemi. Omogućio upravljanje MTR_EN pinom putem MCPWM biblioteke. Omogućio slanje signala koji odgovaraju upravljačkim signalim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
2026-01-02 Pomaknuo Serial.println() naredbe.
2026-01-04 Izmijenio el. šemu kontrolera kako bi odgovarala programskom kodu.
    [Kontroler.kicad_sch]
2026-02-03 Ažurirao KiCAD verziju na 9.0. Promijenio imena motora u shemi.
    [Kontroler.kicad_sch, Robot-auto.kicad_sch]
2026-03-15 Kreirao novi task za očitanje podataka s ADC-a.
2026-03-15 Dizajnirao naponsko djelilo za ulaz u ADC za mjerenje napona iz baterije.
2026-03-15 Napisao funkciju postavljanja gušenja.
    [Kontroler.kicad_sch]
2026-03-24 Napisao jednadžbu za promjenu vrijednosti koju ADC izmjeri u napon na VBAT čvoru. Doradio iznose otpornika u naponskom djelilu.
    [Kontroler.kicad_sch]
2026-03-24 Definirao formulu za pretvorbu očitanog napona u napon na VBAT
    [Kontroler.kicad_sch]
2026-03-24 Dodao NMOS-ove za upravljanje LE-diodama i zujalicom.
    [Kontroler.kicad_sch]
2026-03-24 Dodao NMOS tranzisotre za upravljanje LE-diodama i zujalicom.
    [Robot-auto.kicad_sch]
2026-07-28 Uveo manje promjene.
    [Robot-auto.kicad_sch]
2026-07-31 Promijenio vrstu drivera motora.
    [Robot-auto.kicad_sch]
2026-08-05 Dodao novi oblik upravljanja motorima.
    [Robot-auto.kicad_sch]
2026-08-17 Promijenio mjerače udaljenosti i doradio upravljače motorima.
    [Robot-auto.kicad_sch]
2026-08-18 Dodao otpornike na gate MOSFET-a.
    [Robot-auto.kicad_sch]
2026-08-18 Dodao ostale i doradio vrijednosti otpornika na gate-u MOSFET-a.
    [Kontroler.kicad_sch, Robot-auto.kicad_sch]
2026-08-18 Doradio veze na senzorima udaljenosti.
    [Kontroler.kicad_sch, Robot-auto.kicad_sch]
2026-08-18 Definirao nazive komponenata korištenih za određene dijelova sklopa.
    [Robot-auto.kicad_sch]
2026-08-20 Doradio vrijednosti otpornika na gate MOSFET-a.
    [Kontroler.kicad_sch, Robot-auto.kicad_sch]
2026-08-20 Definirao vrijednosti pasivnih komponenata.
    [Robot-auto.kicad_sch]
2026-08-21 Premjestio neke od komponenata bez promjene čvorova.
    [Robot-auto.kicad_sch]
2026-08-24 Doradio poziciju određenih komponenti.
    [Robot-auto.kicad_sch]
2026-08-24 Dodao definiciju punjača baterije u shemu.
    [Robot-auto.kicad_sch]
2026-08-25 Dodao definicije za neke ključne komponente sustava napajanja preko USB-a.
    [Robot-auto.kicad_sch]
2026-08-26 Promijenio simbol Dasduina.
    [Kontroler.kicad_sch, Robot-auto.kicad_sch]
2026-08-26 Dodao definiciju za PD sink kontroler i nacrtao popratne pasivne komponente.
    [Kontroler.kicad_sch, Robot-auto.kicad_sch]
2026-08-29 Dovršio dizajn USB PD upravljača.
    [Robot-auto.kicad_sch]
2026-08-31 Ažurirao simbol Dasduina.
    [Kontroler.kicad_sch, Robot-auto.kicad_sch]
2026-08-31 Obrnuo oznake otpornika.
    [Robot-auto.kicad_sch]
2026-08-31 Promijenio komponentu koja sadrži par MOSFET-a.
    [Robot-auto.kicad_sch]
2026-08-31 Doradio topologiju koja okružuje Par MOSFET-a.
    [Robot-auto.kicad_sch]
2026-08-31 Doradio šemu MOSFET para.
    [Robot-auto.kicad_sch]
2026-09-01 Dodao konektor za bateriju. Doradio izgled para MOSFET-a.
    [Robot-auto.kicad_sch]
2026-09-01 Dodao opise nazivnih napona kondenzatora.
    [Robot-auto.kicad_sch]
2026-09-01 Doradio očekivani nazivni napon kondenzatora.
    [Robot-auto.kicad_sch]
2026-09-02 Preimenovao čvor koji puni bateriju, dodao kućicu za odabir izvora napona.
    [Robot-auto.kicad_sch]
2026-09-02 Dodao kućicu za prekidača napajanja.
    [Robot-auto.kicad_sch]
2026-09-03 Promijenio pozicije prozorčića u shemi.
    [Robot-auto.kicad_sch]
2026-09-09 Dodao prekidač baterije na prisutan napon napajanja iste.
    [Robot-auto.kicad_sch]
2026-09-09 Definirao korišteni BJT.
    [Robot-auto.kicad_sch]
2026-09-10 Reorganizirao šemu. Doradio neke od footprinta.
    [Robot-auto.kicad_sch]
2026-09-10 Definirao parametre NPN tranzistora.
    [Robot-auto.kicad_sch]
2026-09-10 Dodao footprintove za NPN tranzistor.
    [Robot-auto.kicad_pcb, Robot-auto.kicad_sch]
2026-09-10 Ažurirao izgled komponenti i definirao neke footprinte.
    [Robot-auto.kicad_sch]
2026-09-10 Definirao pasivne i aktivne komponente punjača baterije.
    [Robot-auto.kicad_sch]
2026-09-10 Definirao određene komponente i naveo poveznice na njihova tehnička uputstva.
    [Robot-auto.kicad_sch]
2026-09-11 Definirao neke komponente.
    [Robot-auto.kicad_sch]
2026-09-11 Definirao footprinte za određene komponente.
    [Robot-auto.kicad_sch]
2026-09-11 Definirao footprint za zelene LE-diode.
    [Robot-auto.kicad_sch]
2026-09-11 Definirao određene footprinte.
    [Robot-auto.kicad_sch]
2026-09-11 Definirao ostatak footprinta i doradio neke simbole.
    [Robot-auto.kicad_sch]
2026-09-11 Doradio neke simbole i footprinte.
2026-09-14 Ažurirao neke footprinte i 3D modele.
    [Robot-auto.kicad_pcb, Robot-auto.kicad_sch]
2026-09-16 Ažurirao opise elektroničkih komponenti, ažurirao njihove footprinte, napravio grubi raspored PCB-a.
    [Robot-auto.kicad_pcb, Robot-auto.kicad_sch]
2026-09-16 Doradio određene footprint-ove i simbole.
    [Robot-auto.kicad_pcb, Robot-auto.kicad_sch]
2026-09-17 Doradio shemu prema ERC. Ugrubo rasporedio komponente po PCB-u.
    [Robot-auto.kicad_pcb, Robot-auto.kicad_sch]
2026-09-18 Doradio shemu i PCB dizajn.
    Motori su sada povezani u A+C B+D konfiguraciju.
    [Robot-auto.kicad_pcb, Robot-auto.kicad_sch]
2026-09-18 Definirao jedan dio PCB-a vezan uz upravljače motora.
    [Robot-auto.kicad_pcb, Robot-auto.kicad_sch]
2026-09-19 Doradio PCB oko upravljača motora.
    [Robot-auto.kicad_pcb]
2026-09-19 Doradio poredak linija oko upravljača motora.
    [Robot-auto.kicad_pcb]
2026-09-19 Približio vie koje razvrstavaju linije.
    [Robot-auto.kicad_pcb]
2026-09-19 Dovršio PCB oko upravljača motora.
    [Robot-auto.kicad_pcb]
2026-09-20 Premjestio 100 uF i 100 nF kondenzatore.
    [Robot-auto.kicad_pcb]
2026-09-20 Dodao TVS diode u shemu.
    [Robot-auto.kicad_sch]
2026-09-20 Dodao TVS diode i promijenio konektore za bateriju.
    [Robot-auto.kicad_pcb, Robot-auto.kicad_sch]
2026-09-23 Riješio probleme s DRC kod upravljača motorom.
    [Robot-auto.kicad_pcb]
2026-09-23 Povezao PD sink upravljač s obližnjim komponentama.
    [Robot-auto.kicad_pcb, Robot-auto.kicad_sch]
2026-09-23 Minimalno doradio pozicije CC1 i CC2 linija.
    [Robot-auto.kicad_pcb]
2026-09-23 Dovršio prvu verziju pozicioniranja upravljača punjenja baterije i orkužujućih komponenti.
    [Robot-auto.kicad_pcb]
2026-09-23 Napravio prvu verziju prekidača napona iz baterije i povezao PD upravljač, punjač baterije i upravljač napona iz baterije.
    [Robot-auto.kicad_pcb, Robot-auto.kicad_sch]
2026-09-23 Reorjentirao dovod napona.
    [Robot-auto.kicad_pcb]
2026-09-23 Napravo grubi privremeni raspored već povezanih komponenti.
    [Robot-auto.kicad_pcb, Robot-auto.kicad_sch]
2026-09-23 Prije dupliciranja.
    [Robot-auto.kicad_pcb]
2026-09-23 Povezao komponente LED-ica i zujalice.
    [Robot-auto.kicad_pcb]
2026-09-23 Organizirao layout i oko drugog upravljača motora.
    [Robot-auto.kicad_pcb, Robot-auto.kicad_sch]
2026-09-24 Prime promjene veza pinova Dasduina.
    [Robot-auto.kicad_pcb, Robot-auto.kicad_sch]
2026-09-24 Ugrubo postavio komponente po PCB-u.
    [Robot-auto.kicad_pcb, Robot-auto.kicad_sch]
2026-09-27 Nacrtao 2D model podloge RC auta.
    Na modelu definirao lokacije elektronskih komponenti.
    [RC Podloga tlocrt.dxf, Robot-auto.kicad_pcb]
2026-09-27 Ažurirao verziju KiCada na 10.0.2.
    [Robot-auto.kicad_pcb, Robot-auto.kicad_sch]
2026-09-29 Dodao komponente za izbacivanje dev pločice iz dizajna. Ažurirao USB-C konektor.
    [Robot-auto.kicad_pcb, Robot-auto.kicad_sch]
2026-09-29 Povezao određene dijelove USB-C konektora, USB-UART mosta i ESP32.
    [Robot-auto.kicad_pcb, Robot-auto.kicad_sch]
2026-09-30 Dodao prekidače i pritezne otpornike na pin-ove koje ESP koristi kod boot-a.
    [Robot-auto.kicad_sch]
2026-10-01 Ažurirao PCB s dodanim komponentama.
    [Robot-auto.kicad_pcb, Robot-auto.kicad_sch]
2026-10-02 Dovršio definiciju simbola oko mikroupravljača.
    Simbola vezanih uz USB-UART most i komponente za upravljanje programiranjem i resetiranjem mikroupravljača.
    [Robot-auto.kicad_pcb, Robot-auto.kicad_sch]
2026-10-04 Dodao definicije za pasivne komponente.
    [RC Podloga tlocrt.dxf, Robot-auto.kicad_pcb, Robot-auto.kicad_sch]
2026-10-07 Definirao komponente prekidačkog regulatora.
    [Robot-auto.kicad_pcb, Robot-auto.kicad_sch]
2026-10-07 DOvršio dizajn šeme prije promjene upravljača motora.
    [Robot-auto.kicad_pcb, Robot-auto.kicad_sch]
2026-10-08 Definirao prekidač baterije.
    [#RC Podloga tlocrt.dxf, Robot-auto.kicad_pcb, Robot-auto.kicad_sch]
2026-10-08 Doradio prekidač baterije.
    [Robot-auto.kicad_pcb, Robot-auto.kicad_sch]
2026-10-09 Odradio ERC na shemi.
    [Robot-auto.kicad_pcb, Robot-auto.kicad_sch]
2026-10-09 Dodao 3D model za USB-C priključak.
    [Robot-auto.kicad_pcb, Robot-auto.kicad_sch]
2026-10-09 Povezao diferencijalni par na USB-u.
    [Robot-auto.kicad_pcb, Robot-auto.kicad_sch]
2026-10-09 Ugrubo povezao vodove oko USB-C konektora.
    [Robot-auto.kicad_pcb]
2026-10-10 Ugrubo raspodijelio komponente oko USB na UART mosta.
    [Robot-auto.kicad_pcb]
2026-10-10 Ugrubo dizajnirao raspored predkidačkog regulatora na PCB-u.
    [Robot-auto.kicad_pcb]
2026-10-10 Doradio poveznicu USB-a na USB-UART most kako bi zauzimao manje prostora.
    [Robot-auto.kicad_pcb]
2026-10-10 Ugrubo približio USB za programiranje mikroupravljaču.
    [#RC Podloga tlocrt.dxf, RC Podloga tlocrt.dxf, Robot-auto.kicad_pcb, Robot-auto.kicad_sch]
2026-10-10 Pročistio silkscreen.
    [Robot-auto.kicad_pcb]
2026-10-10 Produžio otvor za kotač na 2D modelu.
    [RC Podloga tlocrt.dxf, Robot-auto.kicad_pcb]
2026-10-10 Promijenio kućište ultrasoničnog senzora kako bi sadržavalo konektor sa stražnje strane.
    [RC Podloga tlocrt.dxf]
2026-10-10 Dodao modele za rupe za šarafe na podlogu autića.
    [RC Podloga tlocrt.dxf]
2026-10-10 Dodao definiciju rupa za montiranje u KiCAD projekt.
    [RC Podloga tlocrt.dxf, Robot-auto.kicad_pcb, Robot-auto.kicad_sch]
2026-10-11 U 2D model dodao obrub baterije i PCB-a.
    [RC Podloga tlocrt.dxf, Robot-auto.kicad_pcb]
2026-10-11 Prije proširenja podloge za 1 cm.
    [RC Podloga tlocrt.dxf]
2026-10-11 Proširio podlogu za 1 cm.
    [RC Podloga tlocrt.dxf]
2026-10-11 Doradio tpolerancije za nosače motora da budu 0,5 mm.
    [RC Podloga tlocrt.dxf]
2026-10-12 Proširio margine PCB-a.
    [RC Podloga tlocrt.dxf]
2026-10-12 Dodao rupe za ziptie.
    [RC Podloga tlocrt.dxf]
2026-10-12 Dodao Lokacije priključaka za motore na PCB obrub u 2D dizajnu.
    [RC Podloga tlocrt.dxf]
2026-10-12 Uveo podlogu u Edge.Cuts sloj na PCB-u.
    [PCB obrub.dxf, RC Podloga tlocrt.dxf, Robot-auto.kicad_pcb]
2026-10-12 Postavio rupe za bušenje na PCB.
    [Robot-auto.kicad_pcb]
2026-10-12 Ugrubo rasporedio komponente po tiskanoj pločici.
    [#RC Podloga tlocrt.dxf, RC Podloga tlocrt.dxf, Robot-auto.kicad_pcb, Robot-auto.kicad_sch]
2026-10-12 Proširio obrub PCB-a u 2D dizajnu.
    [#RC Podloga tlocrt.dxf, RC Podloga tlocrt.dxf, Robot-auto.kicad_pcb, Robot-auto.kicad_sch]
2026-10-12 Ugrubo posložio komponente u prošireni obrub PCB-a.
    [PCB obrub.dxf, RC Podloga tlocrt.dxf, Robot-auto.kicad_pcb]
2026-10-12 Povezano većinu signalnoh vodova, mimo onih koji se vežu na mirkoupravljač.
    [Robot-auto.kicad_pcb, Robot-auto.kicad_sch]
2026-10-12 Preraspodijelio poveznice pin-ova na mikroupravljaču sa signalima.
    [Robot-auto.kicad_pcb, Robot-auto.kicad_sch]
2026-10-12 Povezao neke signalne vodove.
    [Robot-auto.kicad_pcb, Robot-auto.kicad_sch]
2026-10-12 Riješio DRC za loš obrub pločice.
    [Robot-auto.kicad_pcb]
2026-10-12 Okvirno povezao sve komponente PCB-a.
    [#RC Podloga tlocrt.dxf, RC Podloga tlocrt.dxf, Robot-auto.kicad_pcb, Robot-auto.kicad_sch]
2026-10-12 Riješio DRC.
    [Robot-auto.kicad_pcb]
2026-10-12 Dodao GND pour.
    [Robot-auto.kicad_pcb]
2026-10-12 Odradio GND pour i DRC.
    [Robot-auto.kicad_pcb]
2026-10-12 Odradio via stitching.
    [Robot-auto.kicad_pcb]
2026-10-12 Ažurirao simbole upravljača motora.
    [Robot-auto.kicad_sch]
2026-10-12 Doradio površinu GND pour-a i centirrao elektorniku.
    [Robot-auto.kicad_pcb]
2026-10-12 Doradio silkscreen.
    [Robot-auto.kicad_pcb]
2026-10-12 Dodao teardrops.
    [Robot-auto.kicad_pcb]
2026-10-12 Dodao dvije vie.
    [Robot-auto.kicad_pcb]
2026-10-12 Doradio pozicije priključaka za motore kako bi baterija stala ispod PCB-a.
    [#RC Podloga tlocrt.dxf, RC Podloga tlocrt.dxf, Robot-auto.kicad_pcb]
2026-10-12 Napravio prostor kako bi natena mogla bolje primati radiovalove.
    [#RC Podloga tlocrt.dxf, PCB obrub.dxf, RC Podloga tlocrt.dxf, Robot-auto.kicad_pcb]
2026-10-13 Dodao TVS diode kod gumbova.
    [#RC Podloga tlocrt.dxf, RC Podloga tlocrt.dxf, Robot-auto.kicad_pcb, Robot-auto.kicad_sch]
2026-10-14 Doradio pozicije Rupa za bušenje na PCB-u u KiCAD-u.
    [#PCB obrub.dxf, #RC Podloga tlocrt.dxf, RC Podloga tlocrt.dxf, Robot-auto.kicad_pcb]
2026-10-14 Napravio refill zone.
    [Robot-auto.kicad_pcb]
2026-10-15 Ažurirao simbole upravljača motorima.
    [Robot-auto.kicad_sch]
2026-10-17 Dodao pasivne hladnjake u obliku maski za lak na donju stranu PCB-a.
    [Robot-auto.kicad_pcb, Robot-auto.kicad_sch]
2026-10-17 Obrisao nepotrebnu datoteku.
    [#PCB obrub.dxf]
2026-10-17 Napravio neku jednostavnu privremenu arhitekturu Kontrolera.
    [Kontroler.kicad_sch]
2026-10-17 Dodao LC filtar na izlaz prekidačkog regulatora.
    [Robot-auto.kicad_sch]
2026-10-18 Definirao komponente za LC filtar.
    [Robot-auto.kicad_pcb, Robot-auto.kicad_sch]
2026-10-18 Doradio PCB kako bi motori bili spojeni na +5 V i kako bi postojao LC niskopropusni filtar na ulatu u LDO.
    [Robot-auto.kicad_pcb, Robot-auto.kicad_sch]
2026-10-18 Dodao teardropse.
    [Robot-auto.kicad_pcb]
2026-10-18 Dodao malo EMI štita za linije signala.
    [Robot-auto.kicad_pcb]
2026-10-18 Doradio testne točke i diodao neke za GND:
    [Robot-auto.kicad_pcb, Robot-auto.kicad_sch]
2026-10-18 Preimenovao testne točke.
    [Robot-auto.kicad_pcb]
2026-10-19 Definirao prekidač baterije za kontroler.
    [Kontroler.kicad_pcb, Kontroler.kicad_sch, Robot-auto.kicad_pcb]
2026-10-20 Definirao gumbe za upravljanje robot-autom.
    [Kontroler.kicad_sch]
2026-10-20 Okrenuo konektore za motore.
    [Robot-auto.kicad_pcb, Robot-auto.kicad_sch]
2026-10-20 Generirao iBOM i STEP datoteke.
    [Robot-auto.step]
2026-10-20 Ažurirao STEP datoteku kako bi bila manja.
    [Robot-auto.kicad_pcb, Robot-auto.step]
2026-10-21 Doradio prekidač baterijskog napajanja i naponsko djelilo za motrenje napona napajanja.
    [Kontroler.kicad_pcb, Kontroler.kicad_sch]
2026-10-21 Dodefinirao PMOS koji se koristi za prekidanje baterijskog napajanja.
    [Kontroler.kicad_pcb, Kontroler.kicad_sch]
2026-10-21 Ažurirao nacrt obruba PCB-a u LibreCAD-u.
    [Kontroler.kicad_pcb, Kontroler.kicad_sch, RC Podloga tlocrt.dxf]
2026-10-21 Doradio zone area za GND pour.
    [RC Podloga tlocrt.dxf, Robot-auto.kicad_pcb]
2026-10-21 Ažurirao obrub PCB-a.
    [PCB obrub.dxf, RC Podloga tlocrt.dxf, Robot-auto.kicad_pcb, Robot-auto.step]
2026-10-22 Definirao punjač baterije i novi DC-DC pretvarač.
    [Kontroler.kicad_pcb, Kontroler.kicad_sch, RC Podloga tlocrt.dxf, Robot-auto.kicad_pcb, Robot-auto.step]
2026-10-22 Dovršio definiciju sustava napajanja baterije kontrolera.
    [Kontroler.kicad_pcb, Kontroler.kicad_sch, Robot-auto.kicad_pcb, Robot-auto.kicad_sch]
2026-10-22 Dodao labele za prekidač na RA.
    [Robot-auto.kicad_pcb, Robot-auto.kicad_sch]
2026-10-22 Promijenio poziciju STEP modela autića u datotečnoj strukturi.
    [Robot-auto.step]
2026-10-23 DEfinirao početni obrub tiskane pločice za K.
    [K podloga tlocrt.dxf, Robot-auto.kicad_pcb]
2026-10-23 U 2D model za K dodao držač baterije.
    [K podloga tlocrt.dxf]
2026-10-23 Doradio veličinu kućišta za PCB i obrub PCB-a.
    [K podloga tlocrt.dxf]
2026-10-23 Dodao gumbe u 2D K model.
    [K podloga tlocrt.dxf]
2026-10-23 Dodao nožice u tlocrt PCB-a za K.
    [K podloga tlocrt.dxf, Kontroler.kicad_pcb]
2026-10-23 U K podloga tlocrt dodao potenciometar.
    [K podloga tlocrt.dxf]
2026-10-23 Doradio izgled i poziciju držača baterije na tlocrtu podloge K.
    [K podloga tlocrt.dxf]
2026-10-24 Dodao WROVER-E u 2D model K.
    [K podloga tlocrt.dxf, Kontroler.kicad_pcb]
2026-10-24 U KiCAD uveo obrub PCB-a za kontroler.
    [K podloga tlocrt.dxf, Kontroler.kicad_pcb, PCB K obrub.dxf]
2026-10-24 Ažurirao modele za USB priključak i prekidač baterije na K.
    [K podloga tlocrt.dxf, Kontroler.kicad_pcb, Kontroler.kicad_sch, PCB K obrub.dxf]
2026-10-24 Definirao jedan dio PCB-a od K.
    [K podloga tlocrt.dxf, Kontroler.kicad_pcb, Kontroler.kicad_sch]
2026-10-25 Do kraja povezao komponente na K.
    [K podloga tlocrt.dxf, Kontroler.kicad_pcb, Kontroler.kicad_sch]
2026-10-25 Dovršio PCB dizajn za K.
    [Kontroler.kicad_pcb]
2026-10-25 Ažurirao PCB za RC dodefiniravši čvor za hlađenje upravljača motora.
    [Robot-auto.kicad_pcb, Robot-auto.kicad_sch]
2026-10-25 U K PCB-u onemogućio automatsko brisanje otoka bakra.
    [Kontroler.kicad_pcb]
2026-10-25 Generirao iBOM i STEP za K.
    [Kontroler.kicad_pcb, Kontroler.step]
2026-10-25 Ažurirao STEP i iBOM za RA.
    [Robot-auto.kicad_pcb, Robot-auto.step]
2026-10-26 Ažurirao iBOM, exportao .pdf električnih shema.
    [Kontroler.kicad_pcb, Kontroler.kicad_sch, Robot-auto.kicad_pcb, Robot-auto.kicad_sch, Robot-auto.step]
2026-10-26 Dodao testne točke i rupe za montiranje na PCB.
    [Kontroler.kicad_pcb, Kontroler.kicad_sch, Kontroler.step]
2026-10-29 Promijenio poziciju jedne ispitne točke na PCB-u.
    [Kontroler.kicad_pcb]
2026-11-02 Promijenio TVS diode na RA.
    [Robot-auto.kicad_pcb, Robot-auto.kicad_sch]
2026-11-04 Promijenio TVS diode za D+/D- vodove.
    [Kontroler.kicad_pcb, Kontroler.kicad_sch, Kontroler.step, Robot-auto.kicad_pcb, Robot-auto.step]
2026-11-04 Ažurirao STEP datoteke PCB-a.
    [Kontroler.kicad_pcb, Kontroler.step, Robot-auto.kicad_pcb, Robot-auto.step]
2026-11-04 U 2D model K modelirao debljinu kućišta.
    [K podloga tlocrt.dxf]
2026-11-04 Dodao montirajuće rupe u 2D model od K.
    [K podloga tlocrt.dxf, Kontroler.kicad_pcb, PCB K obrub.dxf]
2026-11-08 Isprobao FreeCAD za 3D modeliranje.
    [K Kuciste.FCStd, K podloga tlocrt.dxf, PCB K obrub.dxf, Podloga.FCStd, RC Podloga tlocrt.dxf, RC podloga.dxf]
2026-11-08 Uklonio nepoželjne rupice.
    [Kontroler.kicad_pcb, Robot-auto.kicad_pcb, Robot-auto.kicad_sch]
2026-11-08 Generirao Gerber i Drill datoteke.
    [Kontroler-B_Cu.gbr, Kontroler-B_Mask.gbr, Kontroler-B_Paste.gbr, Kontroler-B_Silkscreen.gbr, Kontroler-Edge_Cuts.gbr, Kontroler-F_Cu.gbr, Kontroler-F_Mask.gbr, Kontroler-F_Paste.gbr]
2026-11-08 Reorganizirao gerber datoteke.
    [Kontroler-NPTH.drl, Kontroler-PTH.drl, Robot-auto-NPTH-drl_map.gbr, Robot-auto-NPTH.drl, Robot-auto-PTH-drl_map.gbr, Robot-auto-PTH.drl]
2026-11-09 Preimenovao datoteke.
    [PCB RC obrub.dxf]
2026-11-09 Ažurirao iBOM za RC i K.
    [Robot-auto.kicad_pcb]
