JakovBegovic/Robot-upravljan-kontrolerom-v2/(notices)

Notices in the files:
README.md:
CC BY-NC-SA 4.0
